jarifalamclaude-max/kill-Switch/docs/board_smd_bottom.png

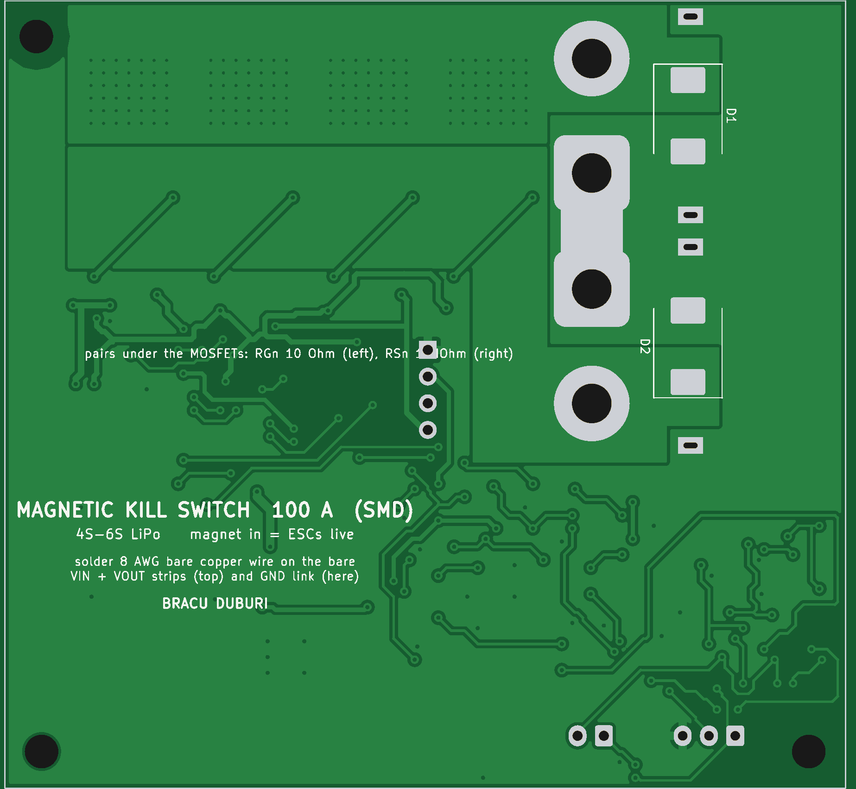
docs/board_smd_bottom.png
