jarifalamclaude-max/kill-Switch/docs/board_smd_layers.png

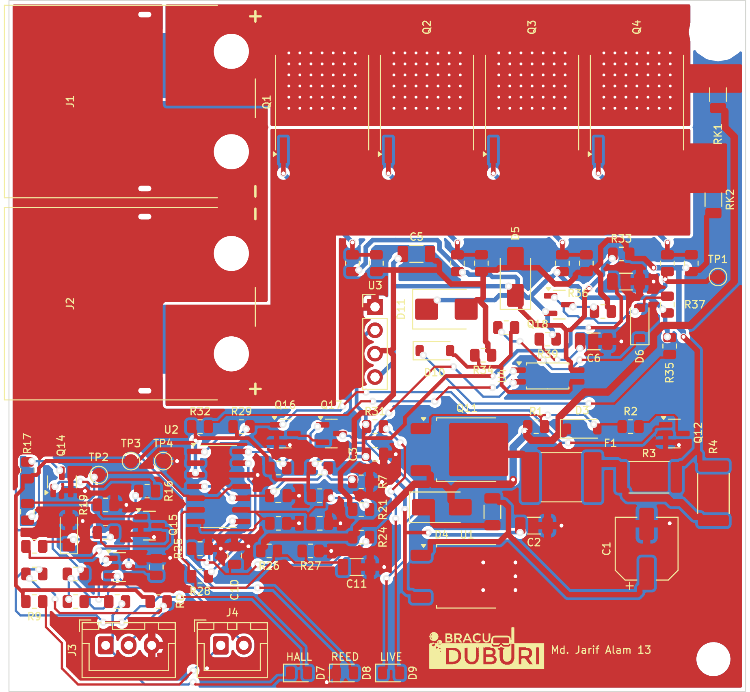
docs/board_smd_layers.png
