jarifalamclaude-max/kill-Switch/docs/board_smd_top.png

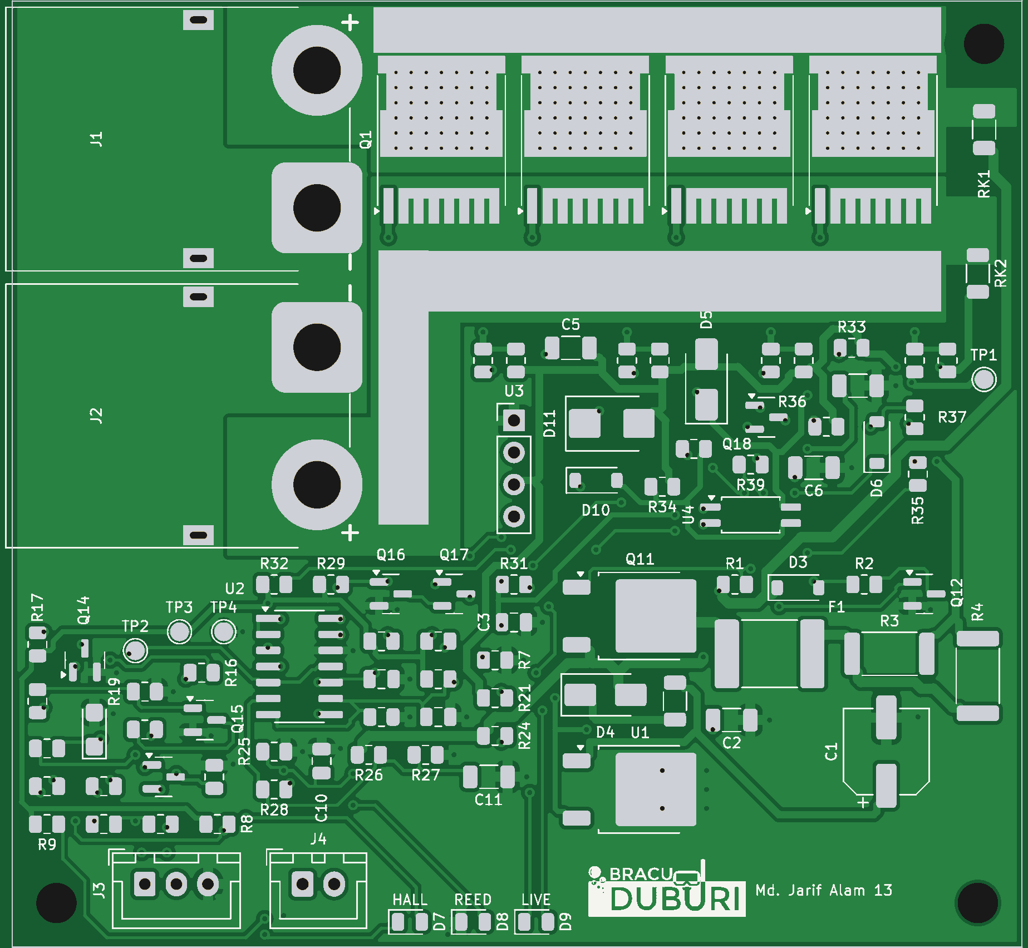
docs/board_smd_top.png
