jarifalamclaude-max/kill-Switch/docs/board_tht_bottom.png

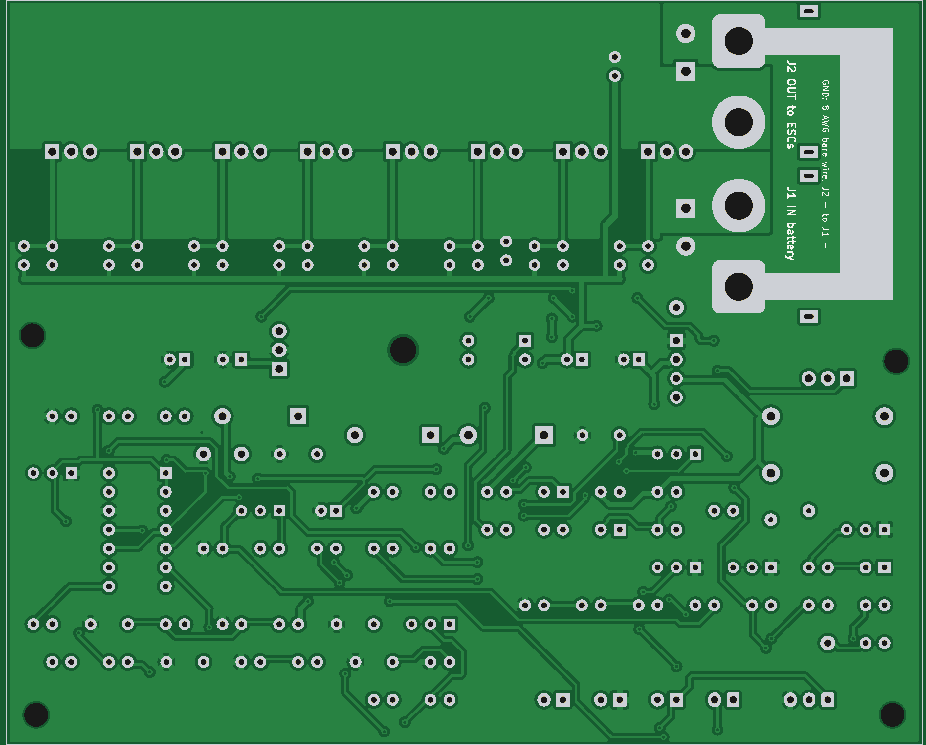
docs/board_tht_bottom.png
