jarifalamclaude-max/kill-Switch/docs/board_tht_layers.png

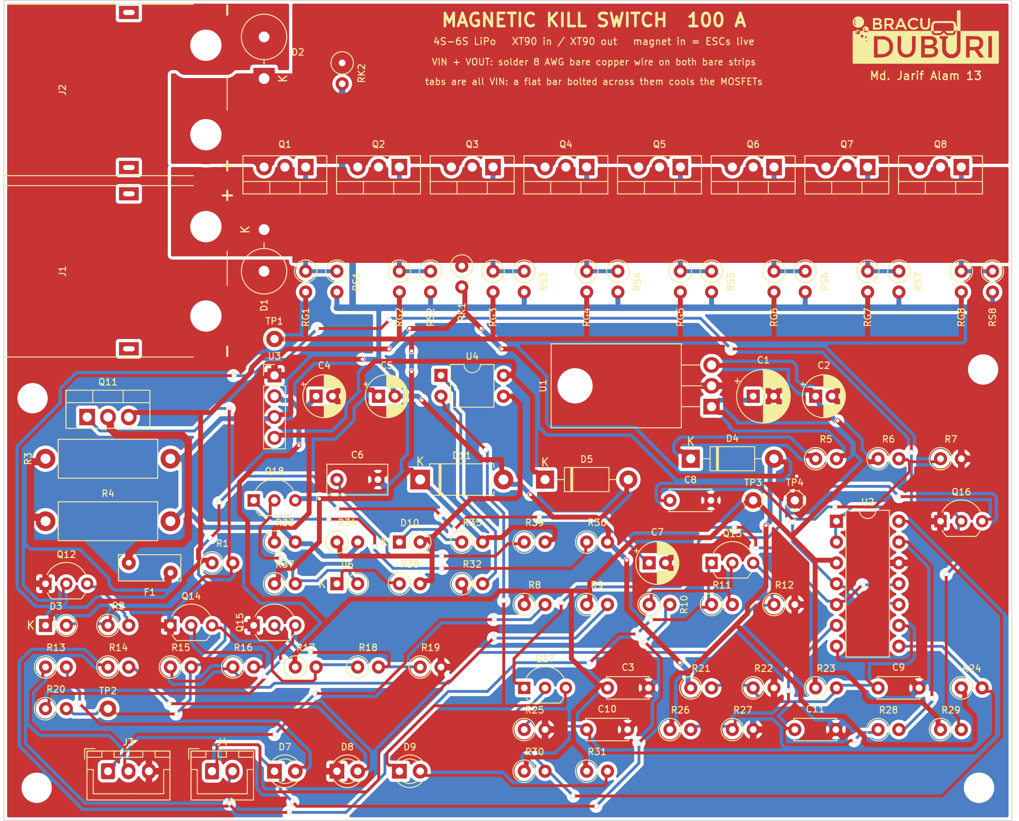
docs/board_tht_layers.png
