jarifalamclaude-max/kill-Switch/docs/board_top.png

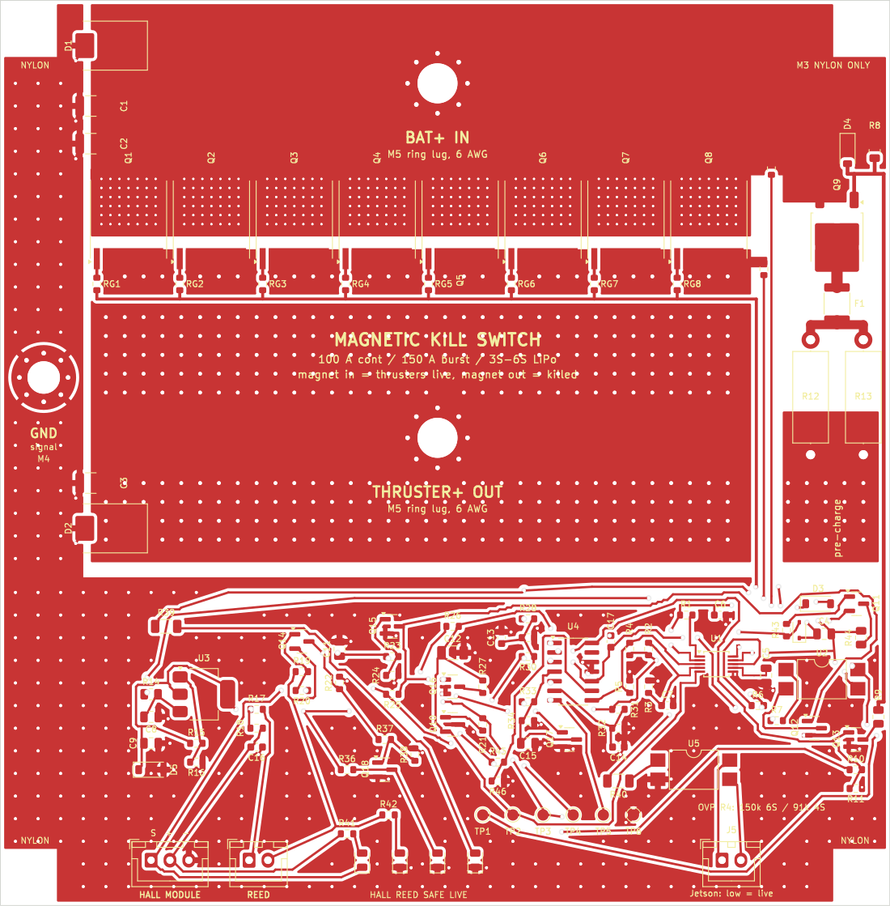
docs/board_top.png
