jarifalamclaude-max/kill-Switch/docs/kill_switch_tht_schematic.png

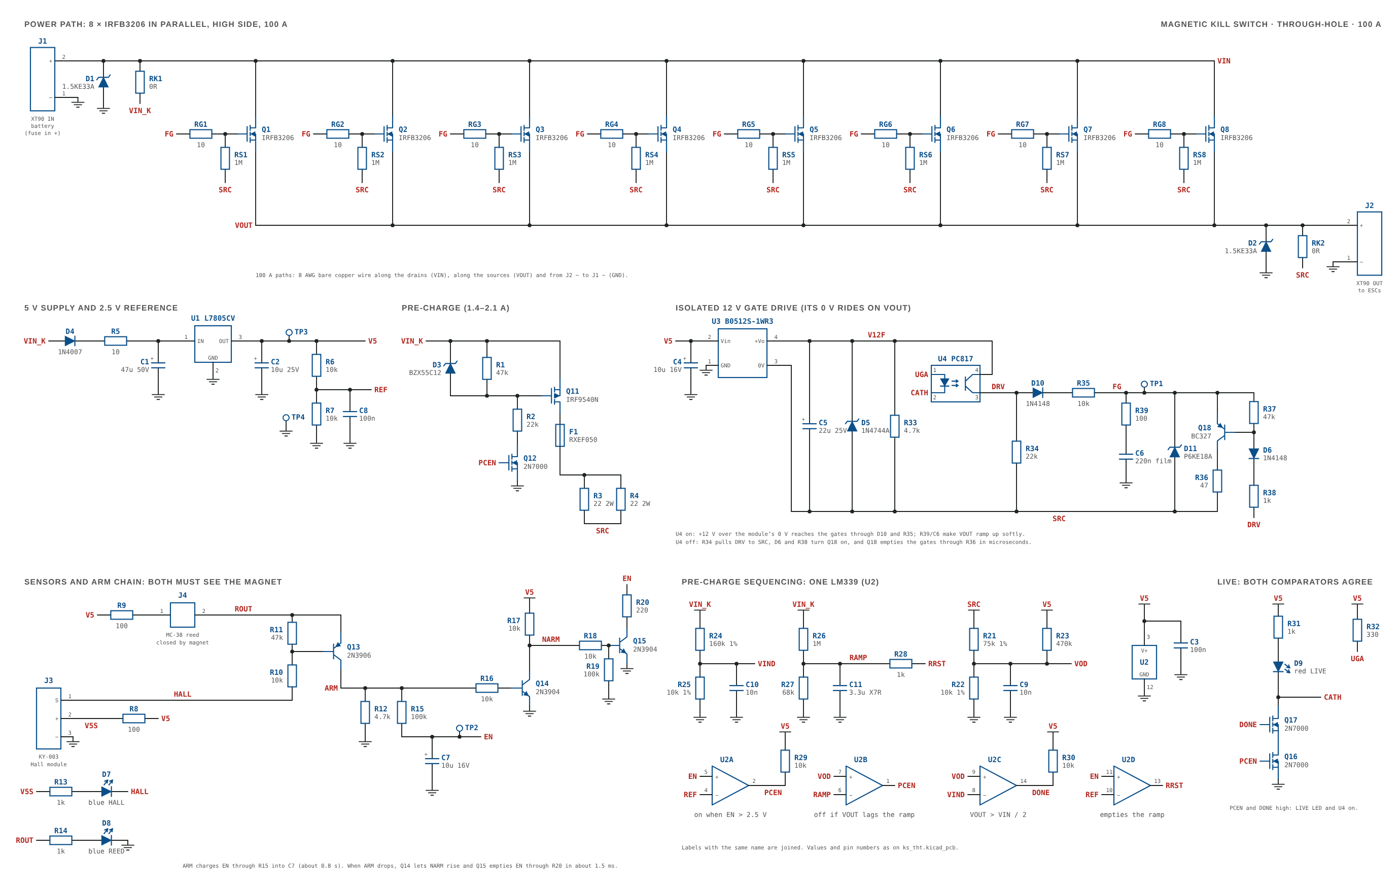
docs/kill_switch_tht_schematic.png
