jarifalamclaude-max/kill-Switch/kicad/simulation/copper_gnd.png

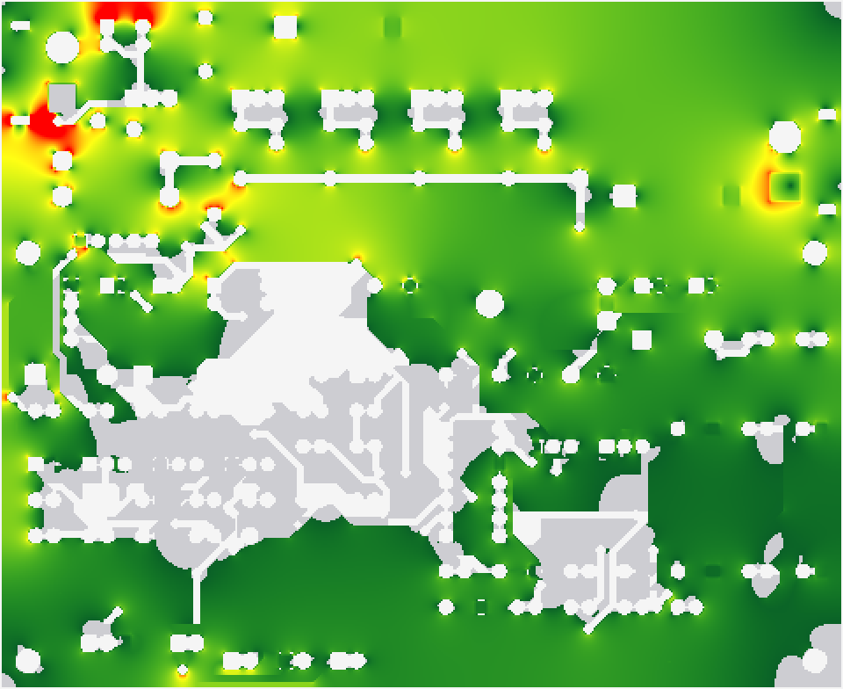
kicad/simulation/copper_gnd.png
