jarifalamclaude-max/kill-Switch/kicad/simulation/copper_gnd_wires.png

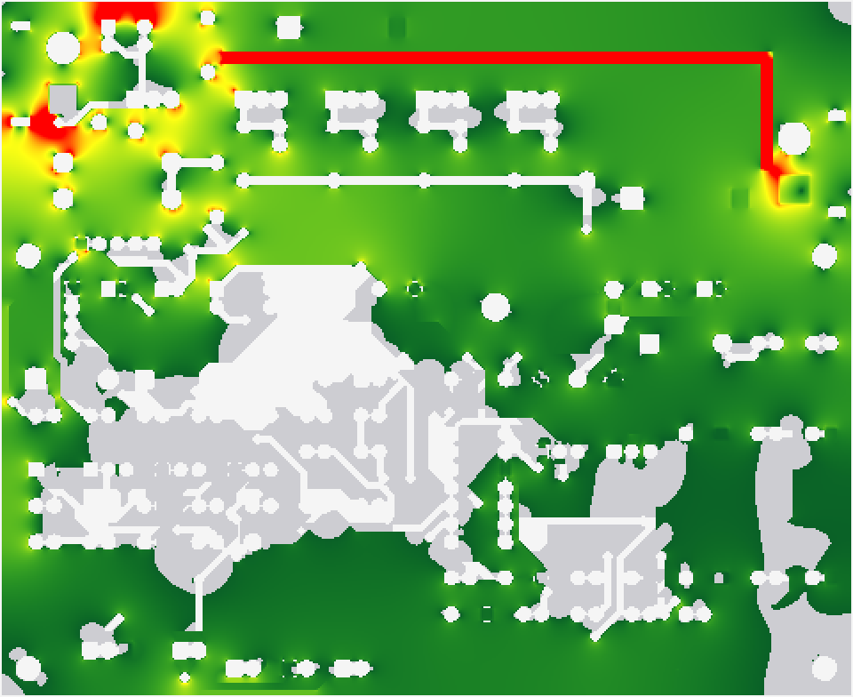
kicad/simulation/copper_gnd_wires.png
