jarifalamclaude-max/kill-Switch/kicad/simulation/copper_smd_gnd.png

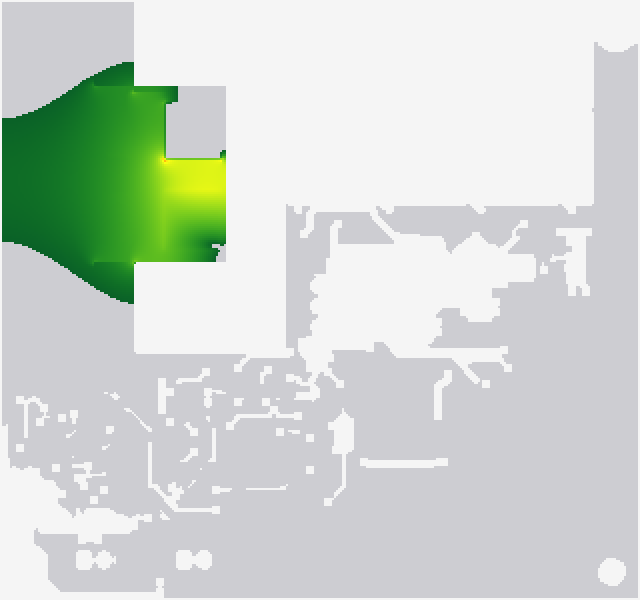
kicad/simulation/copper_smd_gnd.png
