jarifalamclaude-max/kill-Switch/kicad/simulation/copper_smd_gnd_wires.png

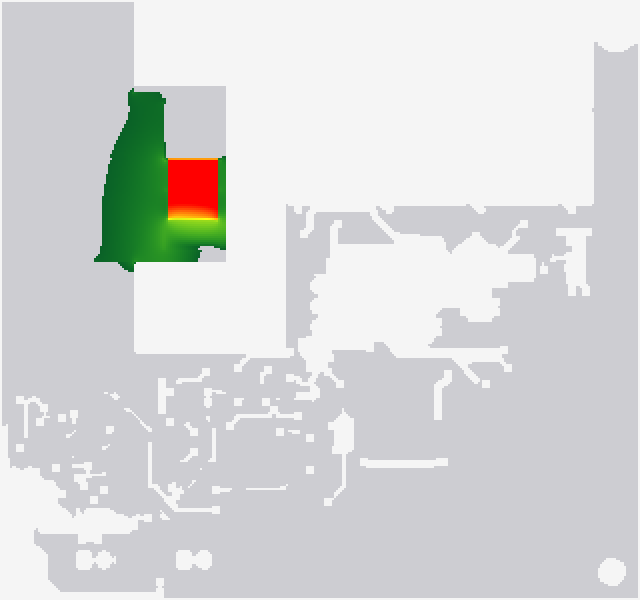
kicad/simulation/copper_smd_gnd_wires.png
