jarifalamclaude-max/kill-Switch/kicad/simulation/copper_smd_vin.png

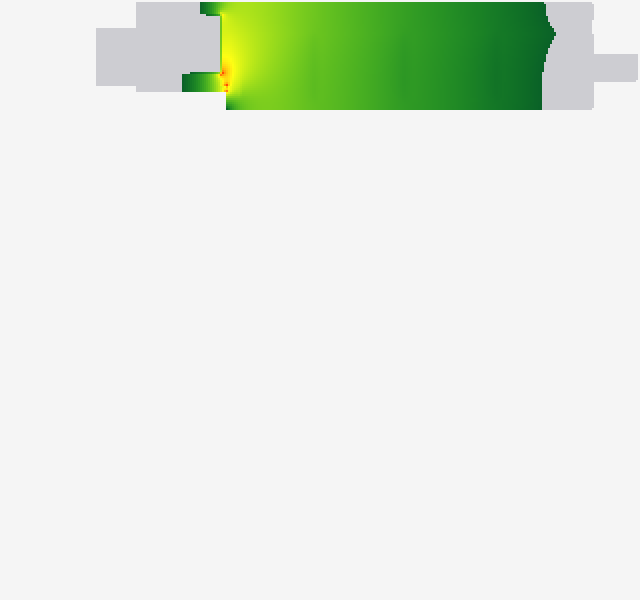
kicad/simulation/copper_smd_vin.png
