jarifalamclaude-max/kill-Switch/kicad/simulation/copper_smd_vout.png

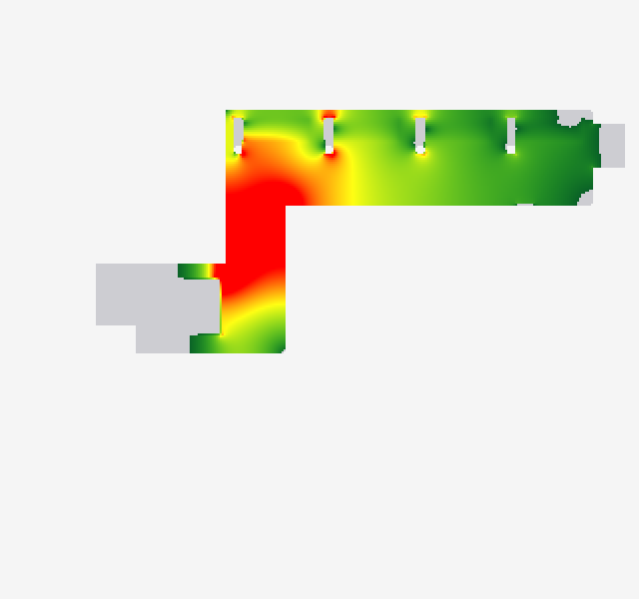
kicad/simulation/copper_smd_vout.png
