jarifalamclaude-max/kill-Switch/kicad/simulation/copper_tht_gnd.png

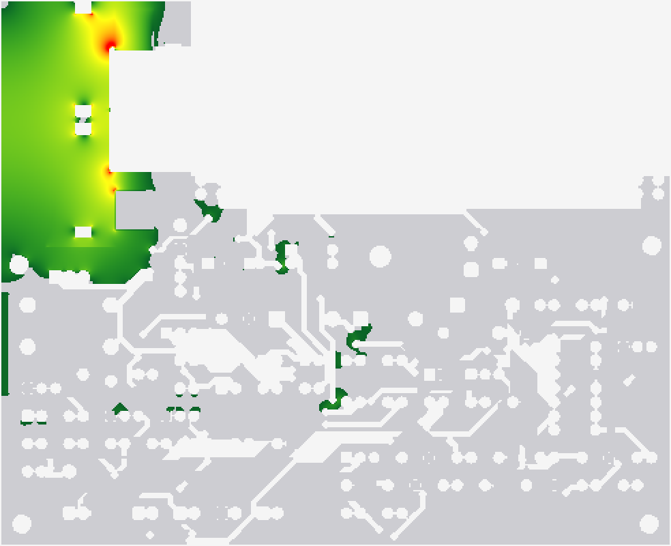
kicad/simulation/copper_tht_gnd.png
