jarifalamclaude-max/kill-Switch/kicad/simulation/copper_tht_vin.png

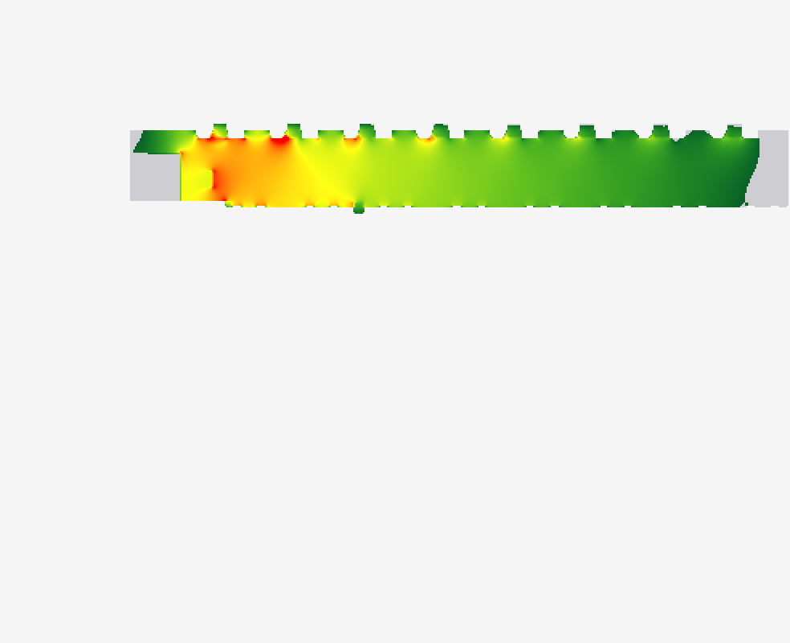
kicad/simulation/copper_tht_vin.png
