jarifalamclaude-max/kill-Switch/kicad/simulation/copper_tht_vin_wires.png

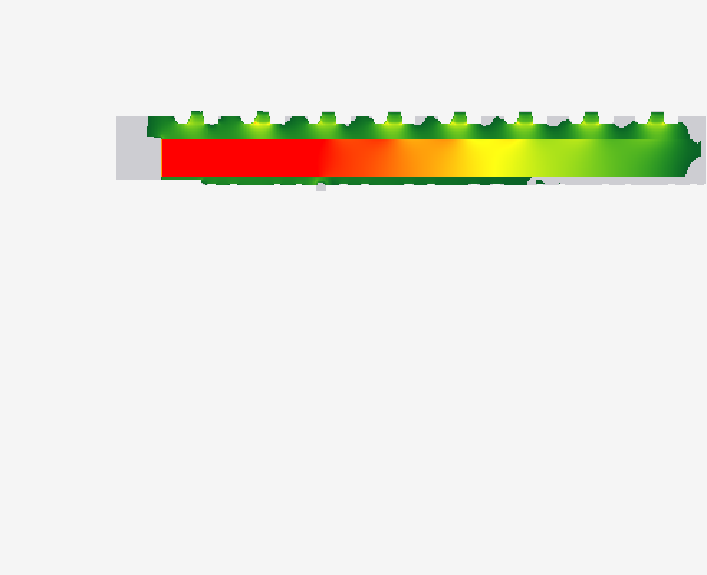
kicad/simulation/copper_tht_vin_wires.png
