jarifalamclaude-max/kill-Switch/kicad/simulation/copper_tht_vout_wires.png

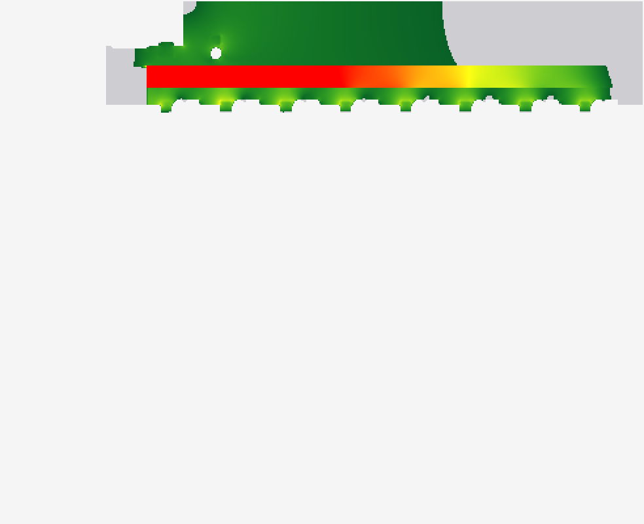
kicad/simulation/copper_tht_vout_wires.png
