jarifalamclaude-max/kill-Switch/kicad/simulation/copper_vin.png

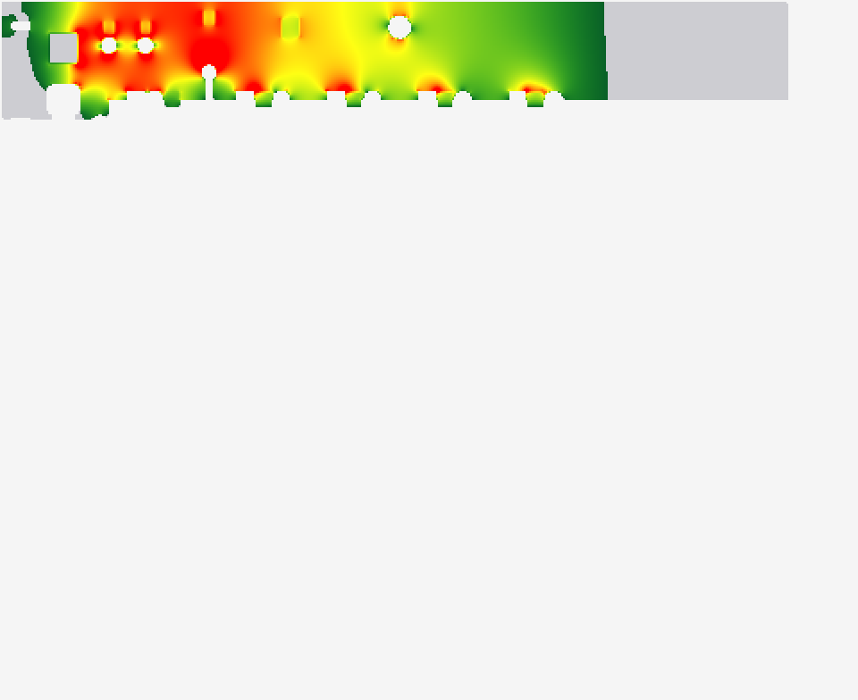
kicad/simulation/copper_vin.png
