jarifalamclaude-max/kill-Switch/kicad/simulation/copper_vin_wires.png

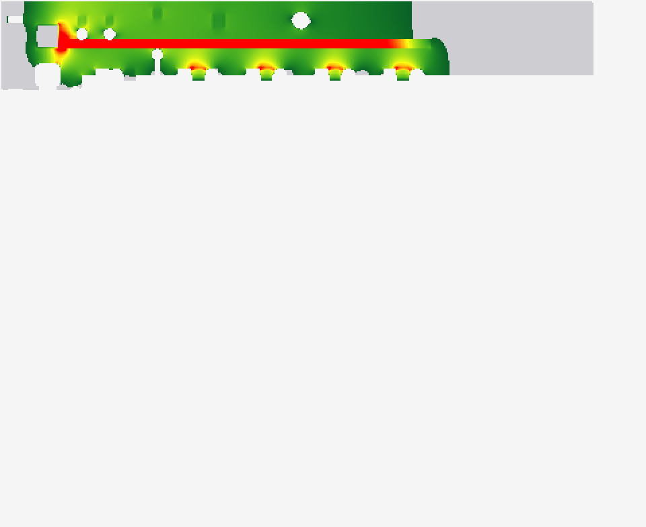
kicad/simulation/copper_vin_wires.png
