jarifalamclaude-max/kill-Switch/kicad/simulation/copper_vout.png

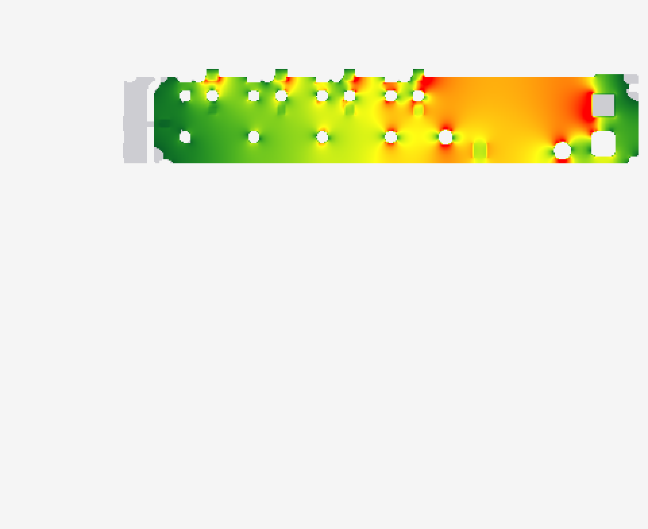
kicad/simulation/copper_vout.png
