jarifalamclaude-max/kill-Switch/kicad/simulation/copper_vout_wires.png

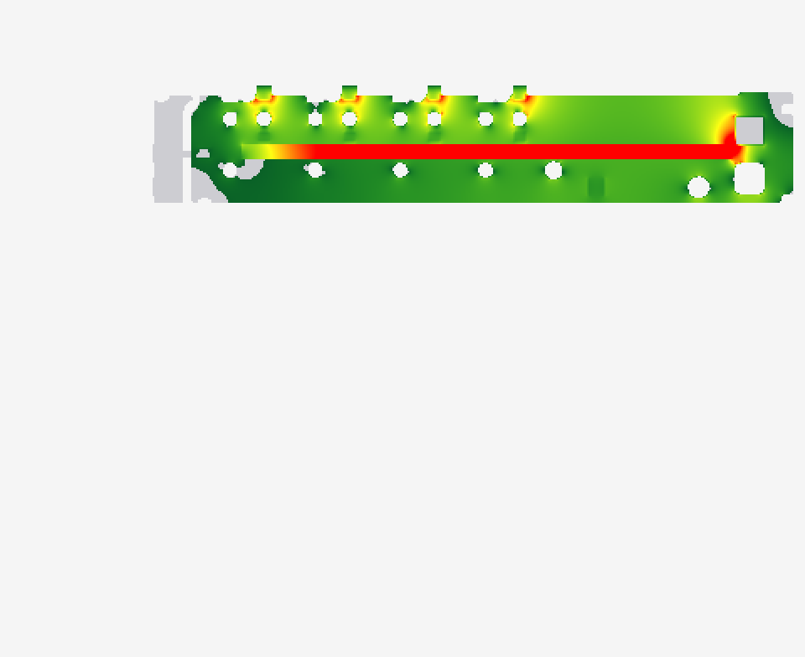
kicad/simulation/copper_vout_wires.png
