jarifalamclaude-max/kill-Switch/pcb-3d/tex_bot.jpg

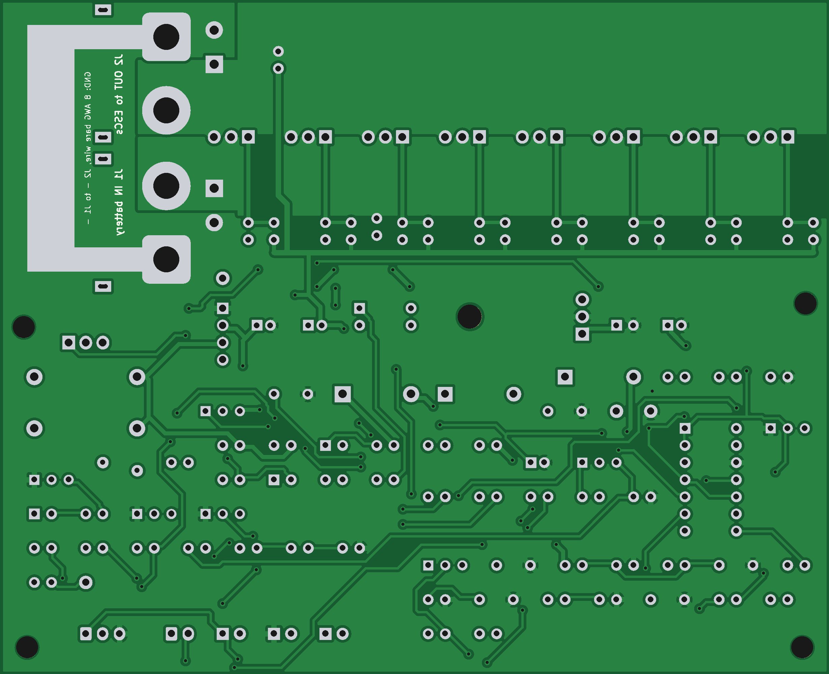
pcb-3d/tex_bot.jpg
