jarifalamclaude-max/kill-Switch/jlcpcb_smd/BOM_ks_smd.csv

Comment | Designator | Footprint | LCSC Part #
47u 50V | C1 | CP_Elec_6.3x7.7
10u 25V | C2,C4 | C_1206_3216Metric
100n | C3,C8 | C_0805_2012Metric
22u 25V | C5 | C_1206_3216Metric
220n 100V X7R | C6 | C_1206_3216Metric
10u 16V tantalum | C7 | CP_EIA-3216-18_Kemet-A
10n | C9,C10 | C_0805_2012Metric
3.3u X7R 50V | C11 | C_1206_3216Metric
SMCJ28A | D1,D2 | D_SMC
BZT52C12 | D3 | D_SOD-123
S1M | D4 | D_SMA
SMAZ15 | D5 | D_SMA
1N4148W | D6,D10 | D_SOD-123
blue HALL | D7 | LED_0805_2012Metric
blue REED | D8 | LED_0805_2012Metric
red LIVE | D9 | LED_0805_2012Metric
SMBJ15A | D11 | D_SMB
MF-SM050/60-2 (0.5 A, 60 V) | F1 | Fuse_2920_7451Metric
XT90PW-M battery IN | J1 | AMASS_XT90PW-M_1x02_P10.90mm_Horizontal
XT90PW-F ESC OUT | J2 | AMASS_XT90PW-F_1x02_P10.90mm_Horizontal
HALL MODULE (KY-003: S + -) | J3 | JST_XH_B3B-XH-A_1x03_P2.50mm_Vertical
REED (MC-38) | J4 | JST_XH_B2B-XH-A_1x02_P2.50mm_Vertical
IPT007N06N | Q1,Q2,Q3,Q4 | Infineon_PG-HSOF-8-1_ThermalVias
FQD11P06 | Q11 | TO-252-2
2N7002 | Q12,Q16,Q17 | SOT-23
MMBT3906 | Q13 | SOT-23
MMBT3904 | Q14,Q15 | SOT-23
BC807-40 | Q18 | SOT-23
47k | R1,R11,R37 | R_0805_2012Metric
22k | R2,R34 | R_0805_2012Metric
22 2512 | R3,R4 | R_2512_6332Metric
10 | R5 | R_1206_3216Metric
10k | R6,R7,R10,R16,R17,R18,R29,R30,R35 | R_0805_2012Metric
100 | R8,R9,R39 | R_0805_2012Metric
4.7k | R12,R33 | R_0805_2012Metric
1k | R13,R14,R28,R31,R38 | R_0805_2012Metric
100k | R15,R19 | R_0805_2012Metric
220 | R20 | R_0805_2012Metric
75k 1% | R21 | R_0805_2012Metric
10k 1% | R22,R25 | R_0805_2012Metric
470k | R23 | R_0805_2012Metric
160k 1% | R24 | R_0805_2012Metric
1M | R26,RS1,RS2,RS3,RS4 | R_0805_2012Metric
68k | R27 | R_0805_2012Metric
330 | R32 | R_0805_2012Metric
47 | R36 | R_0805_2012Metric
10 | RG1,RG2,RG3,RG4 | R_0805_2012Metric
0R | RK1,RK2 | R_1206_3216Metric
L7805CDT | U1 | TO-252-2
LM339D | U2 | SOIC-14_3.9x8.7mm_P1.27mm
B0512S-1WR3 | U3 | PinHeader_1x04_P2.54mm_Vertical
EL357N | U4 | SOP-4_4.4x2.6mm_P1.27mm
