jarifalamclaude-max/kill-Switch/kicad/bom_tht_grouped.csv

qty | value | footprint | refs | buy
1 | 47u 50V | CP_Radial_D6.3mm_P2.50mm | C1 | radial electrolytic 47u 50V
1 | 10u 25V | CP_Radial_D5.0mm_P2.00mm | C2 | radial electrolytic 10u 25V
2 | 100n | C_Disc_D5.0mm_W2.5mm_P5.00mm | C3 C8 | ceramic disc or MLCC radial 100n
2 | 10u 16V | CP_Radial_D5.0mm_P2.00mm | C4 C7 | radial electrolytic 10u 16V
1 | 22u 25V | CP_Radial_D5.0mm_P2.00mm | C5 | radial electrolytic 22u 25V
1 | 220n 100V film | C_Rect_L7.2mm_W3.5mm_P5.00mm_FKS2_FKP2_MKS2_MKP2 | C6 | 220 nF 100 V film (MKT/MKS), 5 mm pitch
2 | 10n | C_Disc_D5.0mm_W2.5mm_P5.00mm | C9 C10 | ceramic disc or MLCC radial 10n
1 | 3.3u X7R 50V | C_Disc_D5.0mm_W2.5mm_P5.00mm | C11 | 3.3 uF 50 V X7R radial ceramic (not electrolytic: its leakage would upset the ramp)
2 | 1.5KE33A | D_DO-201AE_P5.08mm_Vertical_KathodeUp | D1 D2 | 1.5KE33A TVS (DO-201, 1500 W, 28.2 V standoff)
1 | BZX55C12 | D_DO-35_SOD27_P2.54mm_Vertical_KathodeUp | D3 | BZX55C12 zener 12 V (DO-35)
1 | 1N4007 | D_DO-41_SOD81_P10.16mm_Horizontal | D4 | 1N4007 (DO-41)
1 | 1N4744A | D_DO-41_SOD81_P10.16mm_Horizontal | D5 | 1N4744A zener 15 V 1 W (DO-41)
2 | 1N4148 | D_DO-35_SOD27_P2.54mm_Vertical_KathodeUp | D6 D10 | 1N4148 (DO-35)
1 | blue HALL | LED_D3.0mm | D7 | 3 mm LED, blue
1 | blue REED | LED_D3.0mm | D8 | 3 mm LED, blue
1 | red LIVE | LED_D3.0mm | D9 | 3 mm LED, red
1 | P6KE18A | D_DO-15_P10.16mm_Horizontal | D11 | P6KE18A TVS (DO-15, 600 W, 15.3 V standoff)
1 | RXEF050 (0.5 A, 72 V) | Fuse_Bourns_MF-RHT050 | F1 | Littelfuse RXEF050 radial PTC (0.5 A hold, 72 V)
1 | XT90 IN (battery) | AMASS_XT90PW-M_1x02_P10.90mm_Horizontal | J1 | AMASS XT90PW-M (male, PCB right-angle, 2 x 3.8 mm holes) - mates with the battery's XT90; rated 45 A continuous / 90 A burst
1 | XT90 OUT (ESCs) | AMASS_XT90PW-F_1x02_P10.90mm_Horizontal | J2 | AMASS XT90PW-F (female, PCB right-angle) - the ESC harness plugs in here; rated 45 A continuous / 90 A burst
1 | HALL MODULE (KY-003: S + -) | JST_XH_B3B-XH-A_1x03_P2.50mm_Vertical | J3 | JST XH 3-pin header B3B-XH-A + housing XHP-3 for the KY-003 cable
1 | REED (MC-38) | JST_XH_B2B-XH-A_1x02_P2.50mm_Vertical | J4 | JST XH 2-pin header B2B-XH-A + housing XHP-2; MC-38 wired door contact (closed with the magnet)
8 | IRFB3206 | TO-220-3_Vertical | Q1 Q2 Q3 Q4 Q5 Q6 Q7 Q8 | Infineon IRFB3206PbF (TO-220, 60 V, 3.0 mOhm max at 10 V)
1 | IRF9540N | TO-220-3_Vertical | Q11 | IRF9540NPbF (TO-220, -100 V P-MOSFET)
3 | 2N7000 | TO-92_Inline_Wide | Q12 Q16 Q17 | 2N7000 (TO-92, pins S G D)
1 | 2N3906 | TO-92_Inline_Wide | Q13 | 2N3906 (TO-92, pins E B C)
2 | 2N3904 | TO-92_Inline_Wide | Q14 Q15 | 2N3904 (TO-92, pins E B C)
1 | BC327 | TO-92_Inline_Wide | Q18 | BC327-40 (TO-92, pins C B E)
3 | 47k | R_Axial_DIN0207_L6.3mm_D2.5mm_P2.54mm_Vertical | R1 R11 R37 | 1/4 W resistor 5% or 1%, stood up (2.54 mm)
2 | 22k | R_Axial_DIN0207_L6.3mm_D2.5mm_P2.54mm_Vertical | R2 R34 | 1/4 W resistor 5% or 1%, stood up (2.54 mm)
2 | 22 2W | R_Axial_DIN0414_L11.9mm_D4.5mm_P15.24mm_Horizontal | R3 R4 | 22 Ohm 2 W metal oxide or metal film, axial (pulse 1.5 J each)
9 | 10 | R_Axial_DIN0207_L6.3mm_D2.5mm_P2.54mm_Vertical | R5 RG1 RG2 RG3 RG4 RG5 RG6 RG7 RG8 | 1/4 W resistor 5% or 1%, stood up (2.54 mm)
9 | 10k | R_Axial_DIN0207_L6.3mm_D2.5mm_P2.54mm_Vertical | R6 R7 R10 R16 R17 R18 R29 R30 R35 | 1/4 W resistor 5% or 1%, stood up (2.54 mm)
3 | 100 | R_Axial_DIN0207_L6.3mm_D2.5mm_P2.54mm_Vertical | R8 R9 R39 | 1/4 W resistor 5% or 1%, stood up (2.54 mm)
2 | 4.7k | R_Axial_DIN0207_L6.3mm_D2.5mm_P2.54mm_Vertical | R12 R33 | 1/4 W resistor 5% or 1%, stood up (2.54 mm)
5 | 1k | R_Axial_DIN0207_L6.3mm_D2.5mm_P2.54mm_Vertical | R13 R14 R28 R31 R38 | 1/4 W resistor 5% or 1%, stood up (2.54 mm)
2 | 100k | R_Axial_DIN0207_L6.3mm_D2.5mm_P2.54mm_Vertical | R15 R19 | 1/4 W resistor 5% or 1%, stood up (2.54 mm)
1 | 220 | R_Axial_DIN0207_L6.3mm_D2.5mm_P2.54mm_Vertical | R20 | 1/4 W resistor 5% or 1%, stood up (2.54 mm)
1 | 75k 1% | R_Axial_DIN0207_L6.3mm_D2.5mm_P2.54mm_Vertical | R21 | 1/4 W resistor 1%, stood up (2.54 mm)
2 | 10k 1% | R_Axial_DIN0207_L6.3mm_D2.5mm_P2.54mm_Vertical | R22 R25 | 1/4 W resistor 1%, stood up (2.54 mm)
1 | 470k | R_Axial_DIN0207_L6.3mm_D2.5mm_P2.54mm_Vertical | R23 | 1/4 W resistor 5% or 1%, stood up (2.54 mm)
1 | 160k 1% | R_Axial_DIN0207_L6.3mm_D2.5mm_P2.54mm_Vertical | R24 | 1/4 W resistor 1%, stood up (2.54 mm)
9 | 1M | R_Axial_DIN0207_L6.3mm_D2.5mm_P2.54mm_Vertical | R26 RS1 RS2 RS3 RS4 RS5 RS6 RS7 RS8 | 1/4 W resistor 5% or 1%, stood up (2.54 mm)
1 | 68k | R_Axial_DIN0207_L6.3mm_D2.5mm_P2.54mm_Vertical | R27 | 1/4 W resistor 5% or 1%, stood up (2.54 mm)
1 | 330 | R_Axial_DIN0207_L6.3mm_D2.5mm_P2.54mm_Vertical | R32 | 1/4 W resistor 5% or 1%, stood up (2.54 mm)
1 | 47 | R_Axial_DIN0207_L6.3mm_D2.5mm_P2.54mm_Vertical | R36 | 1/4 W resistor 5% or 1%, stood up (2.54 mm)
2 | 0R | R_Axial_DIN0207_L6.3mm_D2.5mm_P2.54mm_Vertical | RK1 RK2 | 0 Ohm jumper (or a wire link)
1 | L7805CV | TO-220-3_Horizontal_TabDown | U1 | L7805CV (TO-220, tab = GND, lies flat on the board); a K7805-500R3 or R-78E5.0-0.5 switching module fits the same holes and runs cool
1 | LM339N | DIP-14_W7.62mm | U2 | LM339N (DIP-14) + socket
1 | B0512S-1WR3 | PinHeader_1x04_P2.54mm_Vertical | U3 | Mornsun B0512S-1WR3 (5 V -> 12 V isolated, 1 W, SIP-4): pins 1 GND, 2 Vin, 3 0V, 4 +Vo - check yours
1 | PC817 | DIP-4_W7.62mm | U4 | PC817 optocoupler (DIP-4)
1 | 8 AWG bare copper wire, about 0.35 m | - | - | solid 8 AWG (3.3 mm, 8.4 mm2) or bare earthing wire: one length on the VOUT strip, one on the VIN strip (top), a C-shaped piece on the GND strip (bottom)
1 | battery fuse 125-150 A | - | - | ANL / MIDI / MEGA fuse in the battery + lead, close to the battery (protects the wiring; the board itself switches off a dead short in under 1 ms)
2 | 8 AWG silicone cable | - | - | battery lead and ESC harness to the XT90 plugs, as short as possible
1 | optional: flat bar 3 x 15 mm, 92 mm long | - | - | copper or aluminium, 8 x M3 screw + nut + spring washer through the MOSFET tabs (all tabs are VIN, no insulators): extra cooling and an extra VIN path
4 | M3 nylon standoff + screw | - | - | board mounting (holes H1-H4)
