jarifalamclaude-max/kill-Switch/kicad/bom_grouped.csv

qty | value | footprint | refs | buy
3 | 2.2u 100V | C_1210_3225Metric | C1 C2 C3 | 1210 X7R ceramic, 100V
1 | 47n 50V | C_0805_2012Metric | C4 | 0805 X7R ceramic, 50V
1 | 470n | C_0805_2012Metric | C5 | 0805 X7R ceramic, 25 V or more
1 | 100n 100V | C_0603_1608Metric | C6 | 0603 X7R ceramic, 100V
3 | 10n | C_0603_1608Metric | C7 C13 C14 | 0603 X7R ceramic, 25 V or more
1 | 1u 50V | C_0805_2012Metric | C8 | 0805 X7R ceramic, 50V
1 | 10u 16V | C_0805_2012Metric | C9 | 0805 X7R ceramic, 16V
1 | 2.2u | C_0805_2012Metric | C11 | 0805 X7R ceramic, 25 V or more
1 | 22u 16V | C_1206_3216Metric | C12 | 1206 X7R ceramic, 16V
1 | 3.3u | C_0805_2012Metric | C15 | 0805 X7R ceramic, 25 V or more
2 | 100n | C_0603_1608Metric | C16 C17 | 0603 X7R ceramic, 25 V or more
1 | SMDJ26A | D_SMC | D1 | Littelfuse SMDJ26A (3 kW TVS, 26 V standoff, SMC)
1 | SMCJ26A | D_SMC | D2 | Littelfuse SMCJ26A (1.5 kW TVS, 26 V standoff, SMC)
1 | BZT52C15 | D_SOD-123 | D3 | BZT52C series zener, SOD-123
1 | BZT52C12 | D_SOD-123 | D4 | BZT52C series zener, SOD-123
1 | BZT52C6V2 | D_SOD-123 | D5 | BZT52C series zener, SOD-123
1 | blue HALL | LED_0805_2012Metric | D6 | 0805 LED, blue
1 | blue REED | LED_0805_2012Metric | D7 | 0805 LED, blue
1 | green SAFE | LED_0805_2012Metric | D8 | 0805 LED, green
1 | BAT54WS | D_SOD-323 | D9 | BAT54WS Schottky, SOD-323
1 | PTC 0.5A 30V 1812 | Fuse_1812_4532Metric | F1 | 1812 PTC fuse, hold 0.5 A, rated 30 V or more (60 V better for 6S) - verify the rating
1 | BAT+ IN (M5) | MountingHole_5.3mm_M5_Pad_Via | J1 | M5 ring lug, 6 AWG or thicker cable, M5 brass/stainless bolt + nut
1 | THRUSTER+ OUT (M5) | MountingHole_5.3mm_M5_Pad_Via | J2 | M5 ring lug, 6 AWG or thicker cable, M5 brass/stainless bolt + nut
1 | GND (M4) | MountingHole_4.3mm_M4_Pad_Via | J3 | M4 ring lug, thin wire to battery minus (logic ground only)
1 | HALL MODULE (KY-003: S + -) | JST_XH_B3B-XH-A_1x03_P2.50mm_Vertical | J4 | JST XH 3-pin header B3B-XH-A + housing XHP-3 for the KY-003 cable
1 | STATUS to Jetson | JST_XH_B2B-XH-A_1x02_P2.50mm_Vertical | J5 | JST XH 2-pin header B2B-XH-A + housing XHP-2
1 | REED CONTACT (MC-38) | JST_XH_B2B-XH-A_1x02_P2.50mm_Vertical | J6 | JST XH 2-pin header B2B-XH-A + housing XHP-2 for the MC-38 cable
1 | red LIVE | LED_0805_2012Metric | LED1 | 0805 LED, red
8 | IPT007N06N | Infineon_PG-HSOF-8-1_ThermalVias | Q1 Q2 Q3 Q4 Q5 Q6 Q7 Q8 | Infineon IPT007N06N (60 V, 0.75 mOhm max, TOLL)
1 | FQD11P06 | TO-252-2 | Q9 | onsemi FQD11P06TM (-60 V P-FET, DPAK)
2 | MMBT3906 | SOT-23 | Q10 Q11 | MMBT3906 PNP, SOT-23
6 | 2N7002 | SOT-23 | Q12 Q13 Q15 Q16 Q17 Q18 | 2N7002 N-FET, SOT-23
1 | BSS84 | SOT-23 | Q14 | BSS84 P-FET, SOT-23
1 | 4.32k 1% | R_0603_1608Metric | R1 | 0603 resistor 1%
2 | 47k | R_0603_1608Metric | R2 R34 | 0603 resistor 1% or 5%
5 | 10k | R_0603_1608Metric | R3 R5 R20 R23 R37 | 0603 resistor 1% or 5%
1 | 150k | R_0603_1608Metric | R4 | 0603 resistor 1% or 5%
7 | 100k | R_0603_1608Metric | R6 R10 R19 R24 R25 R26 R38 | 0603 resistor 1% or 5%
5 | 1k | R_0603_1608Metric | R7 R36 R41 R42 R43 | 0603 resistor 1% or 5%
1 | 47k | R_0805_2012Metric | R8 | 0805 resistor 1% or 5%
1 | 22k | R_0805_2012Metric | R9 | 0805 resistor 1% or 5%
3 | 1M | R_0603_1608Metric | R11 R30 R33 | 0603 resistor 1% or 5%
2 | 22 2W | R_Axial_DIN0414_L11.9mm_D4.5mm_P15.24mm_Horizontal | R12 R13 | 22 Ohm 2 W metal oxide or metal film, axial (pulse 1.5 J each)
1 | 10 | R_0805_2012Metric | R14 | 0805 resistor 1% or 5%
1 | 240 1% | R_0603_1608Metric | R15 | 0603 resistor 1%
1 | 750 1% | R_0603_1608Metric | R16 | 0603 resistor 1%
2 | 100 | R_0603_1608Metric | R17 R18 | 0603 resistor 1% or 5%
1 | 4.7k | R_0603_1608Metric | R21 | 0603 resistor 1% or 5%
1 | 2.2k | R_0603_1608Metric | R22 | 0603 resistor 1% or 5%
9 | 10 | R_0603_1608Metric | R27 RG1 RG2 RG3 RG4 RG5 RG6 RG7 RG8 | 0603 resistor 1% or 5%
1 | 90.9k 1% | R_0603_1608Metric | R28 | 0603 resistor 1%
3 | 10k 1% | R_0603_1608Metric | R29 R32 R46 | 0603 resistor 1%
1 | 191k 1% | R_0603_1608Metric | R31 | 0603 resistor 1%
1 | 4.7k | R_1206_3216Metric | R39 | 1206 resistor 1% or 5%
1 | 10k | R_1206_3216Metric | R40 | 1206 resistor 1% or 5%
1 | 220 | R_0805_2012Metric | R44 | 0805 resistor 1% or 5%
1 | 15.8k 1% | R_0603_1608Metric | R45 | 0603 resistor 1%
1 | 0R (VIN Kelvin) | R_0603_1608Metric | RK1 | 0603 resistor 1% or 5%, 0 Ohm jumper
1 | 0R (VOUT Kelvin) | R_0603_1608Metric | RK2 | 0603 resistor 1% or 5%, 0 Ohm jumper
1 | LM5060 | MSOP-10_3x3mm_P0.5mm | U1 | TI LM5060MM/NOPB (VSSOP-10)
1 | PC817 (gate kill) | SMDIP-4_W9.53mm | U2 | Sharp/Everlight PC817 SMD (SMDIP-4, gull wing)
1 | LM317 | SOT-223-3_TabPin2 | U3 | LM317 in SOT-223 (e.g. LM317DCYR)
1 | LM339 | SOIC-14_3.9x8.7mm_P1.27mm | U4 | LM339DR or LM339ADR (SOIC-14)
1 | PC817 (status) | SMDIP-4_W9.53mm | U5 | Sharp/Everlight PC817 SMD (SMDIP-4, gull wing)
