jarifalamclaude-max/kill-Switch/kicad/3dmodels/JST_XH_B2B-XH-A_1x02_P2.50mm_Vertical.step

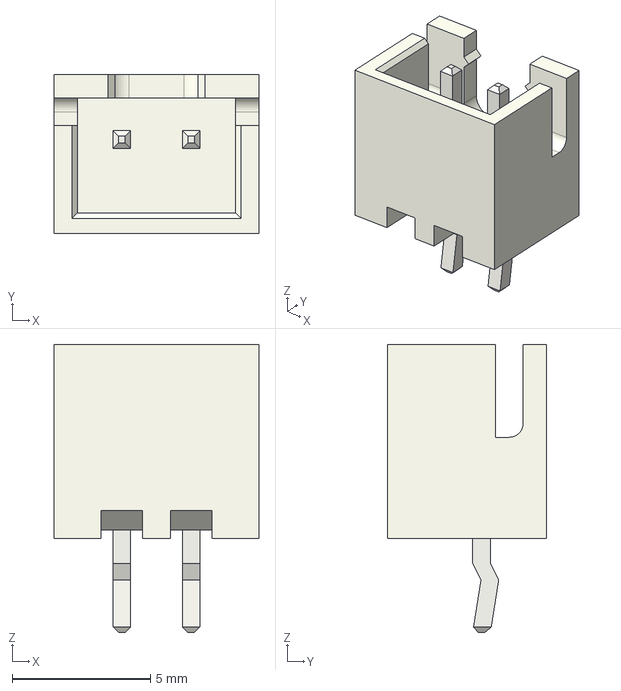
[picture p24: CAD file, 2026-11-12]
kicad/3dmodels/JST_XH_B2B-XH-A_1x02_P2.50mm_Vertical.step
7.40 x 5.75 x 10.4 mm
