jarifalamclaude-max/kill-Switch/mech/bracket.stl

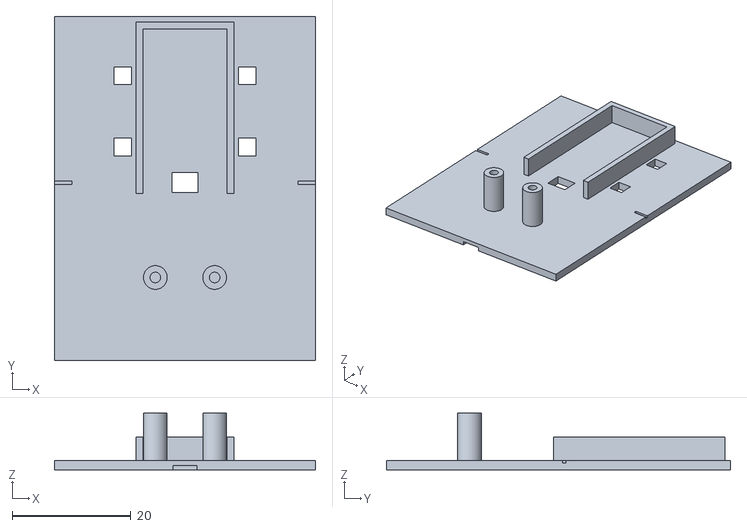
[picture p25: CAD file, 2026-11-12]
mech/bracket.stl
44.0 x 58.0 x 9.60
