jarifalamclaude-max/kill-Switch/kicad/3dmodels/CP_Radial_D6.3mm_P2.50mm.step

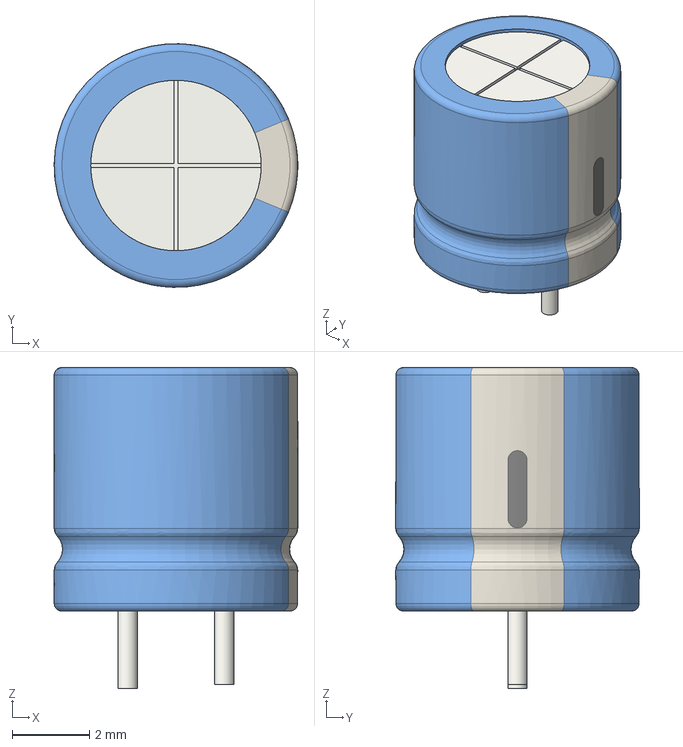
[picture p26: CAD file, 2026-11-12]
kicad/3dmodels/CP_Radial_D6.3mm_P2.50mm.step
6.30 x 6.30 x 8.30 mm
