jarifalamclaude-max/kill-Switch/mech/handle.stl

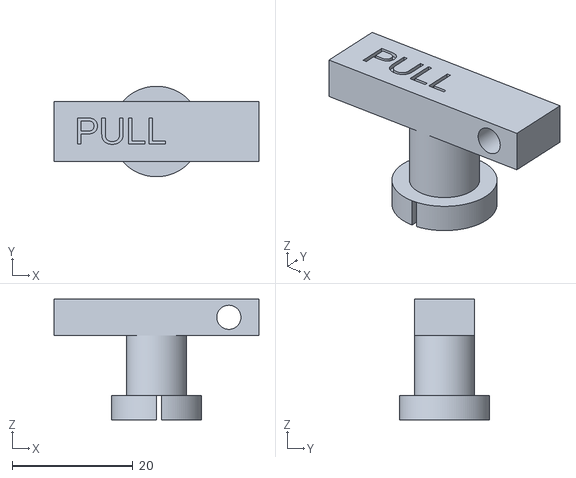
[picture p27: CAD file, 2026-11-12]
mech/handle.stl
34.0 x 15.0 x 20.0
