jarifalamclaude-max/kill-Switch/kicad/3dmodels/C_Rect_L7.2mm_W3.5mm_P5.00mm_FKS2_FKP2_MKS2_MKP2.step

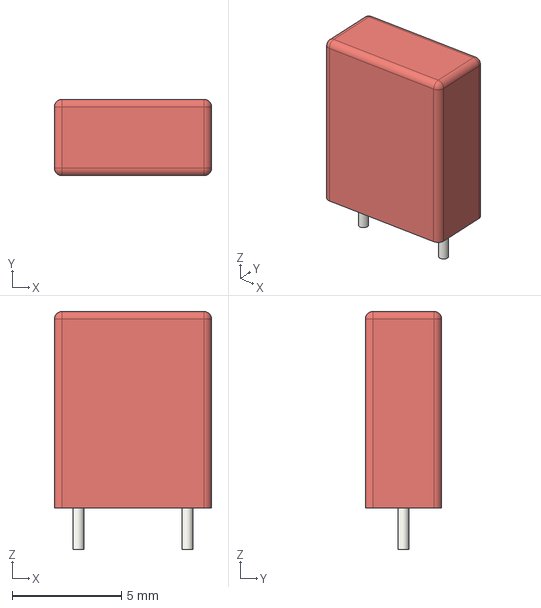
[picture p28: CAD file, 2026-11-12]
kicad/3dmodels/C_Rect_L7.2mm_W3.5mm_P5.00mm_FKS2_FKP2_MKS2_MKP2.step
7.20 x 3.50 x 10.9 mm
