jarifalamclaude-max/kill-Switch/mech/plug.stl

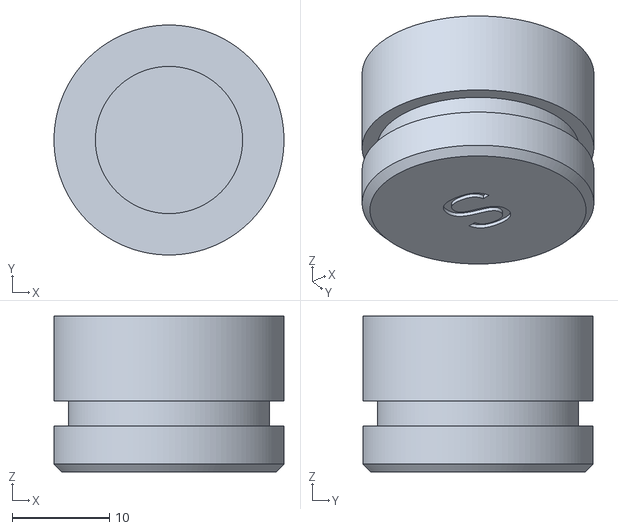
[picture p29: CAD file, 2026-11-12]
mech/plug.stl
23.6 x 23.6 x 16.0
