jarifalamclaude-max/kill-Switch/mech/dock.stl

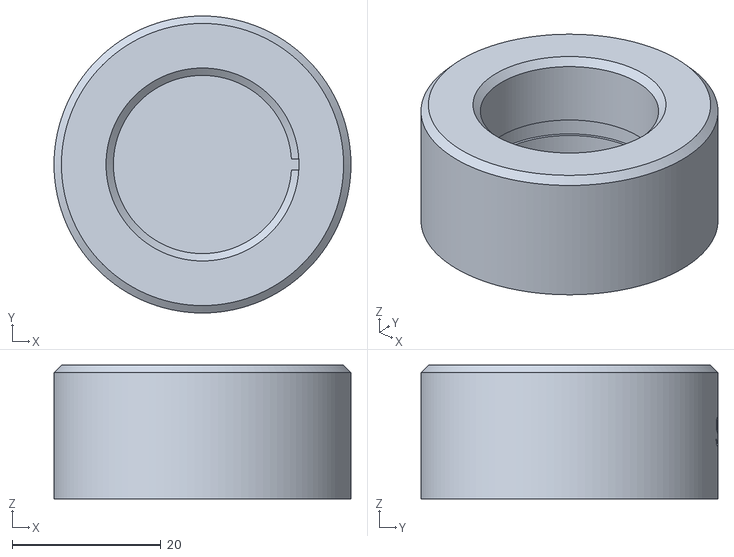
[picture p31: CAD file, 2026-11-12]
mech/dock.stl
40.0 x 40.0 x 18.0
