jarifalamclaude-max/kill-Switch/kicad/3dmodels/CP_EIA-3216-18_Kemet-A.step

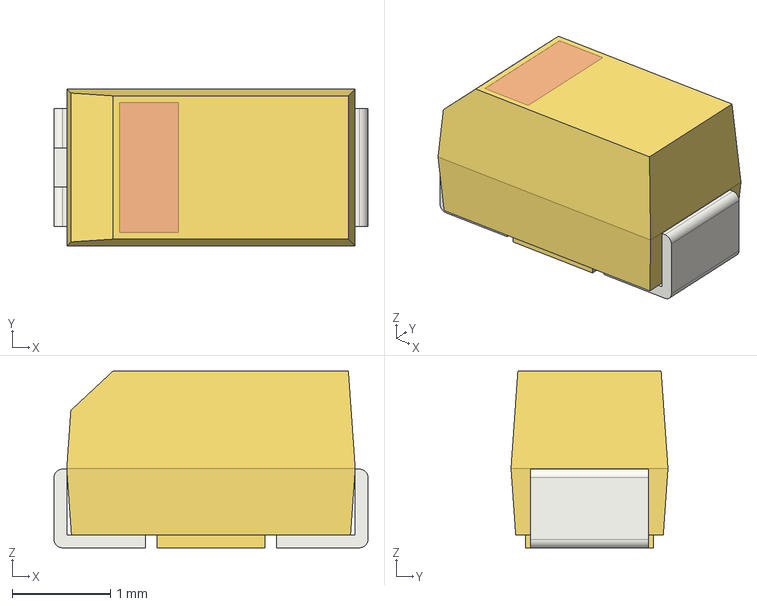
[picture p32: CAD file, 2026-11-12]
kicad/3dmodels/CP_EIA-3216-18_Kemet-A.step
3.20 x 1.60 x 1.80 mm
