jarifalamclaude-max/kill-Switch/kicad/3dmodels/PinHeader_1x04_P2.54mm_Vertical.step

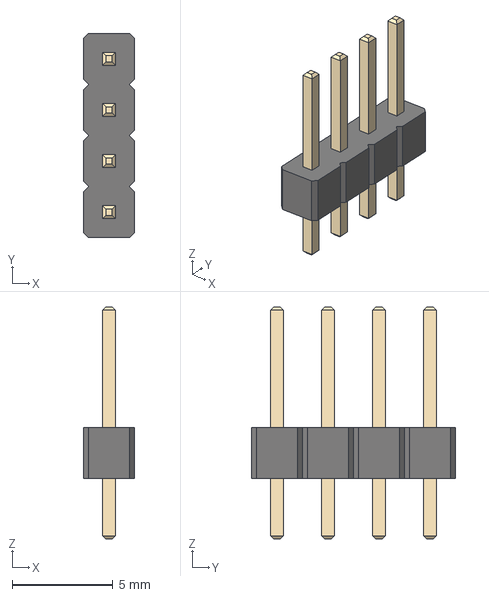
[picture p33: CAD file, 2026-11-12]
kicad/3dmodels/PinHeader_1x04_P2.54mm_Vertical.step
2.54 x 10.2 x 11.5 mm
