jarifalamclaude-max/kill-Switch/kicad/3dmodels/SOIC-14_3.9x8.7mm_P1.27mm.step

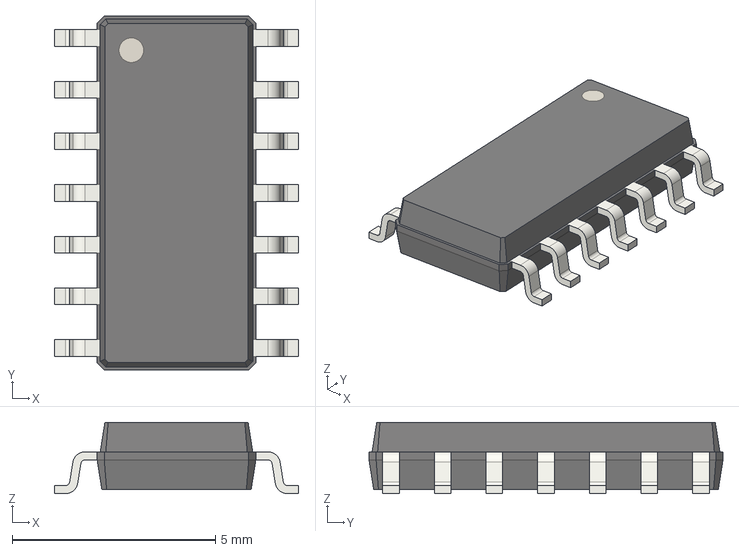
[picture p34: CAD file, 2026-11-12]
kicad/3dmodels/SOIC-14_3.9x8.7mm_P1.27mm.step
6.00 x 8.70 x 1.75 mm
