jarifalamclaude-max/kill-Switch/kicad/3dmodels/R_0805_2012Metric.step

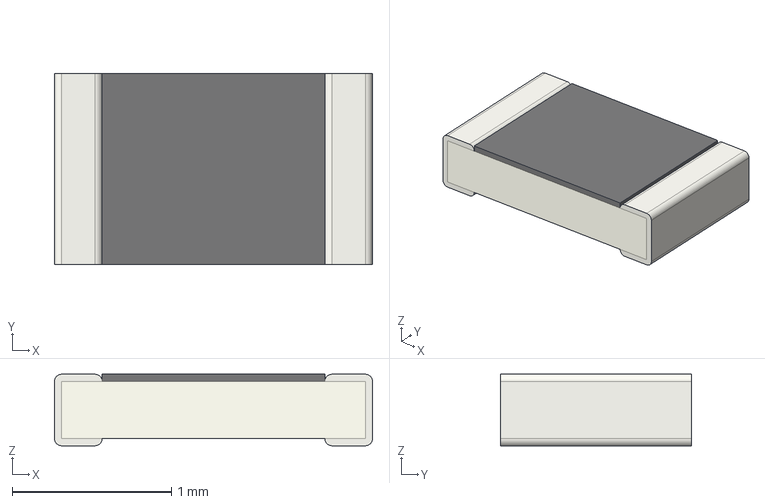
[picture p35: CAD file, 2026-11-12]
kicad/3dmodels/R_0805_2012Metric.step
2.00 x 1.20 x 0.45 mm
