jarifalamclaude-max/kill-Switch/kicad/3dmodels/C_0805_2012Metric.step

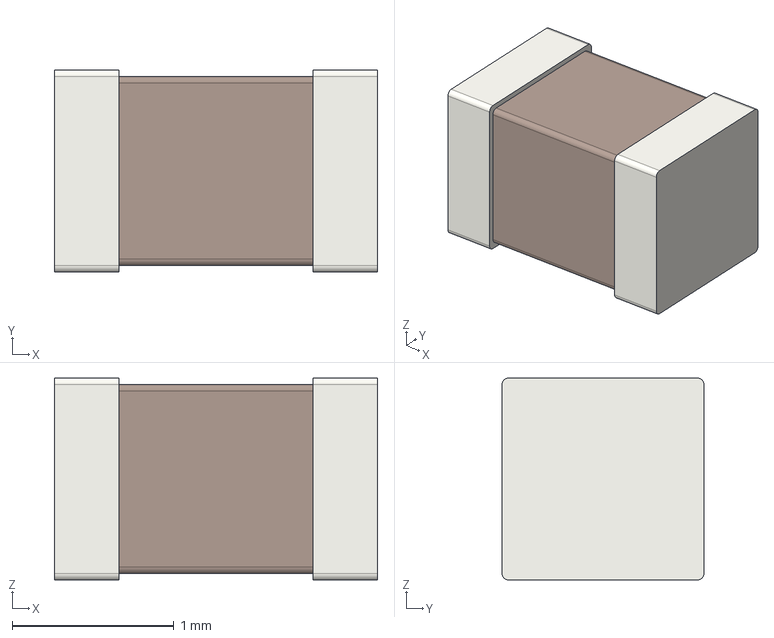
[picture p36: CAD file, 2026-11-12]
kicad/3dmodels/C_0805_2012Metric.step
2.00 x 1.25 x 1.25 mm
