jarifalamclaude-max/kill-Switch/kicad/3dmodels/D_DO-35_SOD27_P2.54mm_Vertical_KathodeUp.step

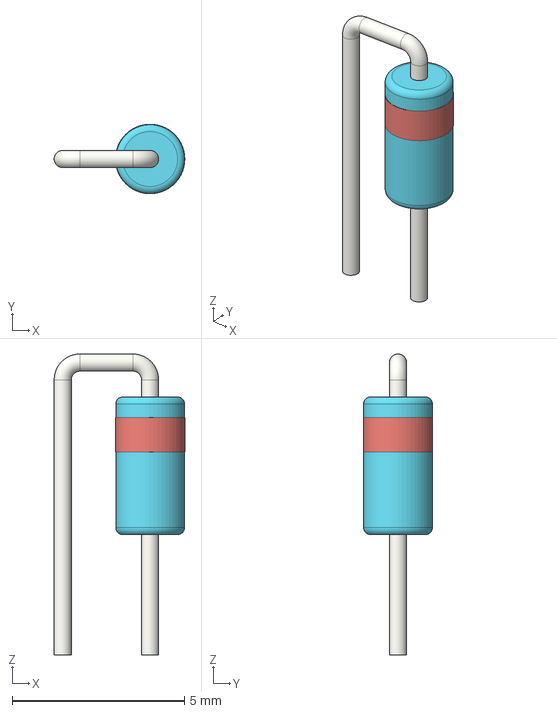
[picture p37: CAD file, 2026-11-12]
kicad/3dmodels/D_DO-35_SOD27_P2.54mm_Vertical_KathodeUp.step
3.80 x 2.02 x 8.75 mm
