jarifalamclaude-max/kill-Switch/kicad/3dmodels/D_SMA.step

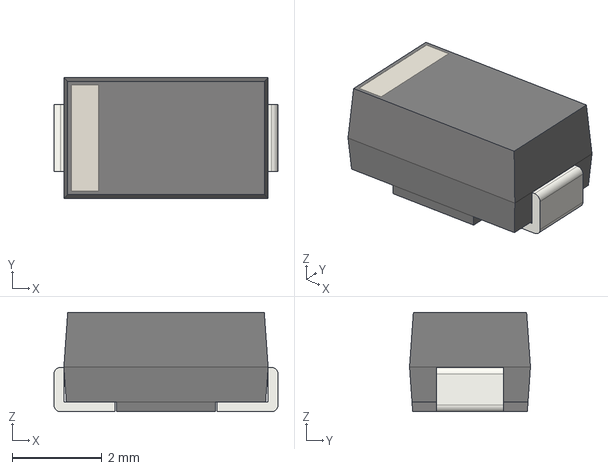
[picture p38: CAD file, 2026-11-12]
kicad/3dmodels/D_SMA.step
5.00 x 2.70 x 2.22 mm
