jarifalamclaude-max/kill-Switch/kicad/3dmodels/JST_XH_B3B-XH-A_1x03_P2.50mm_Vertical.step

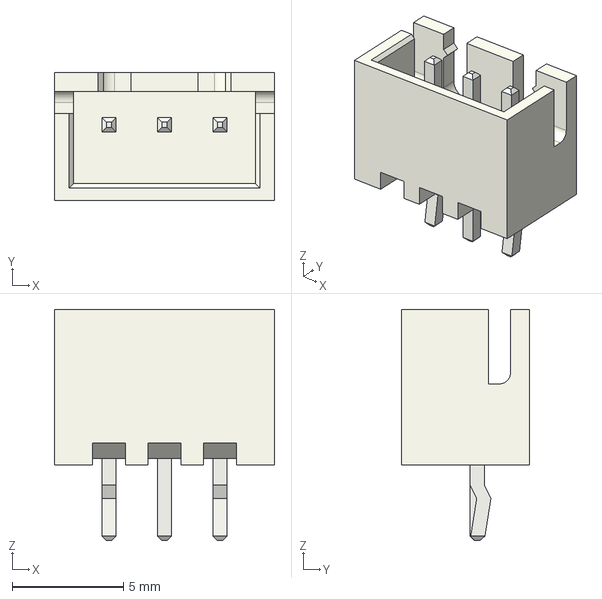
[picture p39: CAD file, 2026-11-12]
kicad/3dmodels/JST_XH_B3B-XH-A_1x03_P2.50mm_Vertical.step
9.90 x 5.75 x 10.4 mm
