jarifalamclaude-max/kill-Switch/kicad/3dmodels/D_DO-201AE_P5.08mm_Vertical_KathodeUp.step

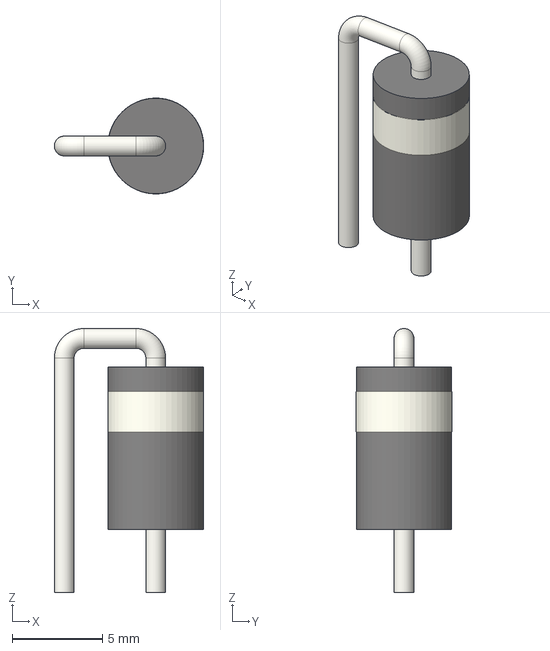
[picture p40: CAD file, 2026-11-12]
kicad/3dmodels/D_DO-201AE_P5.08mm_Vertical_KathodeUp.step
8.29 x 5.32 x 14.6 mm
