jarifalamclaude-max/kill-Switch/kicad/3dmodels/C_1206_3216Metric.step

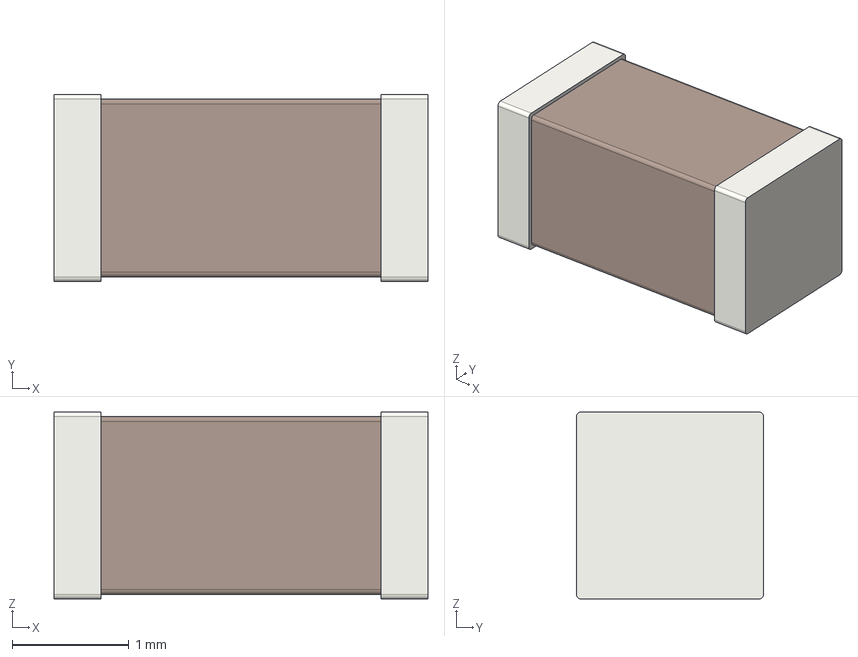
[picture p41: CAD file, 2026-11-12]
kicad/3dmodels/C_1206_3216Metric.step
3.20 x 1.60 x 1.60 mm
