jarifalamclaude-max/kill-Switch/kicad/3dmodels/DIP-4_W7.62mm.step

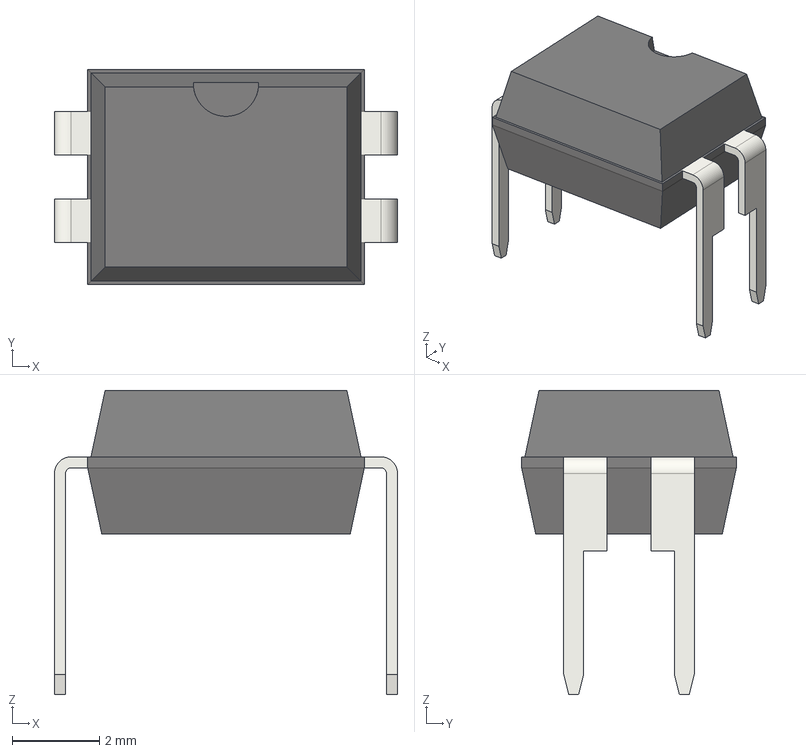
[picture p42: CAD file, 2026-11-12]
kicad/3dmodels/DIP-4_W7.62mm.step
7.87 x 4.93 x 6.98 mm
