jarifalamclaude-max/kill-Switch/kicad/3dmodels/TO-220-3_Horizontal_TabDown.step

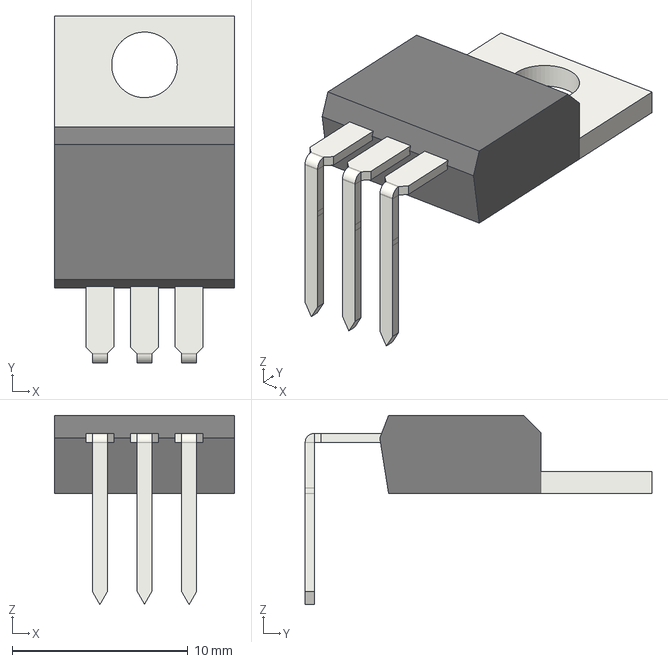
[picture p43: CAD file, 2026-11-12]
kicad/3dmodels/TO-220-3_Horizontal_TabDown.step
10.2 x 19.7 x 10.8 mm
