jarifalamclaude-max/kill-Switch/kicad/3dmodels/R_Axial_DIN0414_L11.9mm_D4.5mm_P15.24mm_Horizontal.step

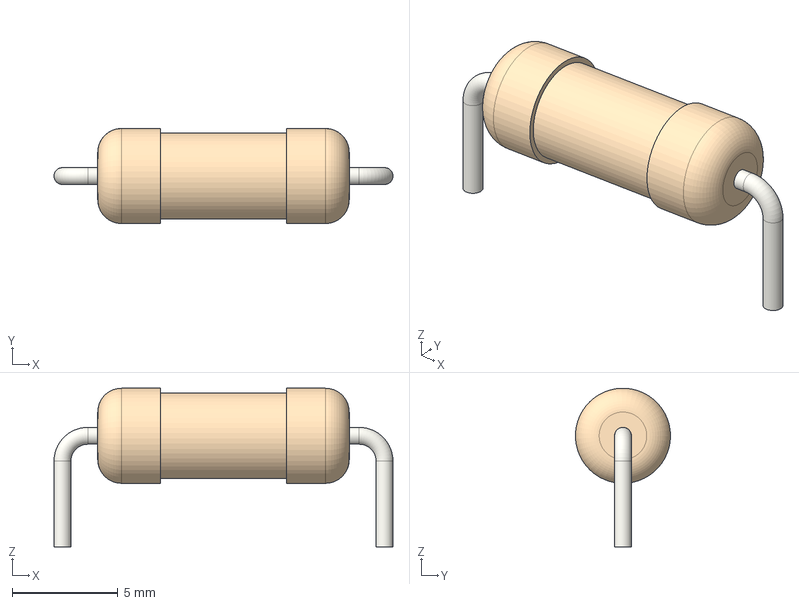
[picture p44: CAD file, 2026-11-12]
kicad/3dmodels/R_Axial_DIN0414_L11.9mm_D4.5mm_P15.24mm_Horizontal.step
16.0 x 4.50 x 7.50 mm
