jarifalamclaude-max/kill-Switch/kicad/3dmodels/R_Axial_DIN0207_L6.3mm_D2.5mm_P2.54mm_Vertical.step

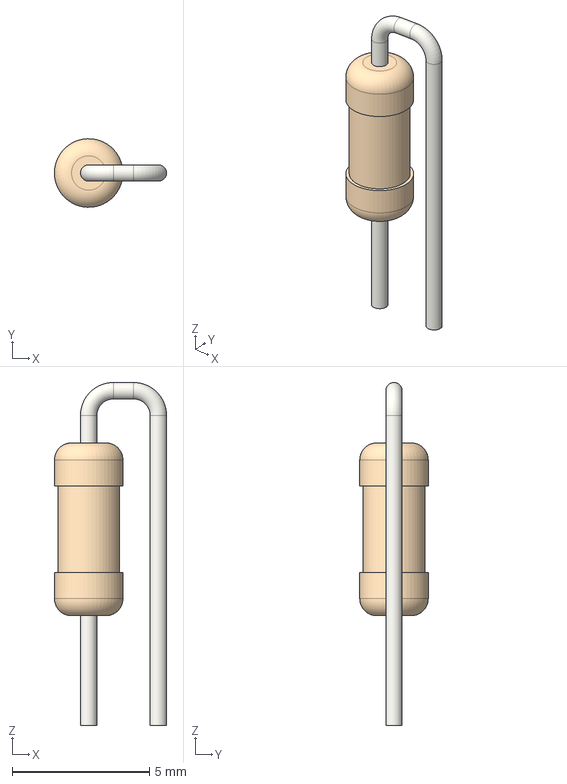
[picture p45: CAD file, 2026-11-12]
kicad/3dmodels/R_Axial_DIN0207_L6.3mm_D2.5mm_P2.54mm_Vertical.step
4.09 x 2.50 x 12.5 mm
