jarifalamclaude-max/kill-Switch/kicad/3dmodels/CP_Elec_6.3x7.7.step

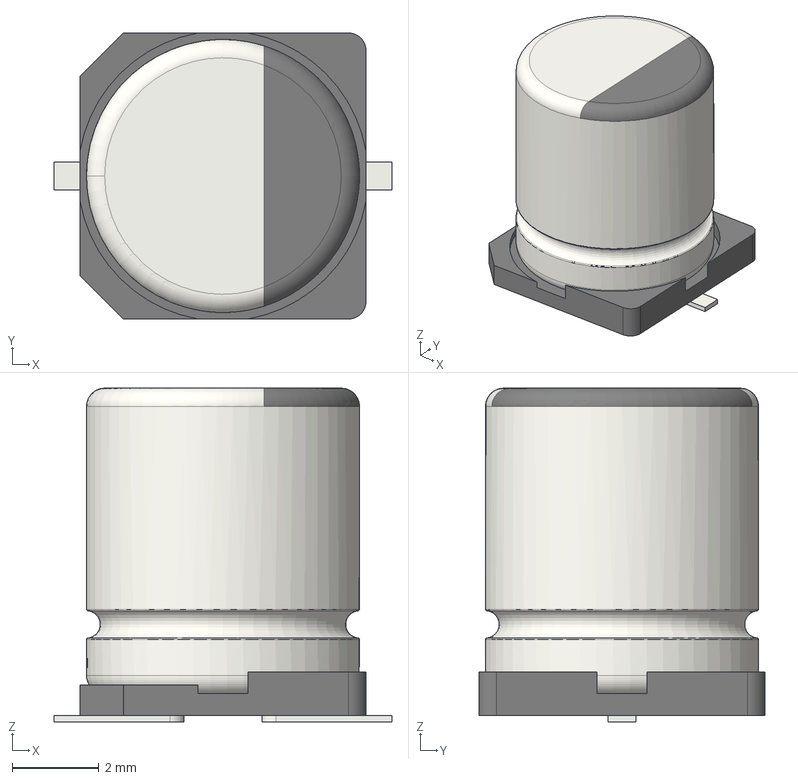
[picture p46: CAD file, 2026-11-12]
kicad/3dmodels/CP_Elec_6.3x7.7.step
7.80 x 6.60 x 7.70 mm
