jarifalamclaude-max/kill-Switch/kicad/3dmodels/D_SMB.step

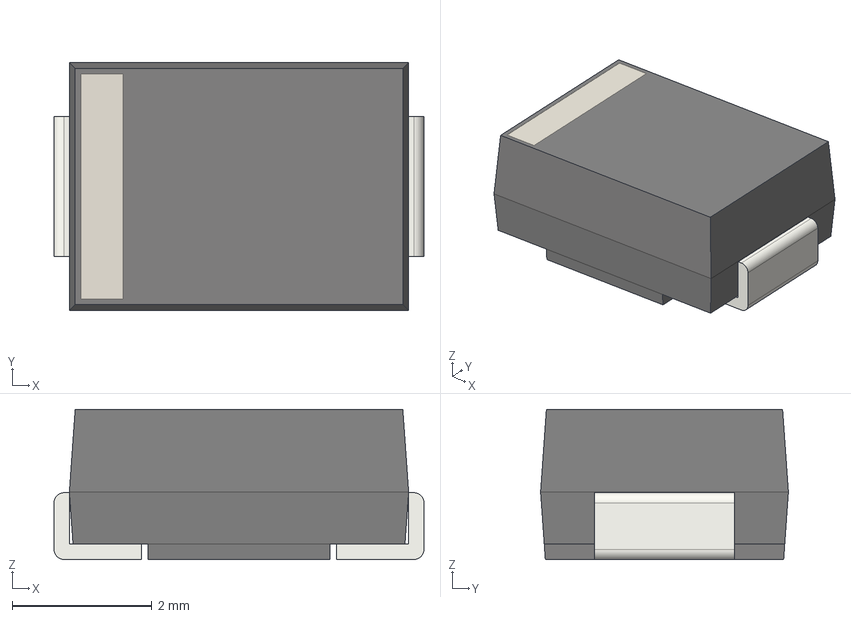
[picture p47: CAD file, 2026-11-12]
kicad/3dmodels/D_SMB.step
5.30 x 3.55 x 2.15 mm
