jarifalamclaude-max/kill-Switch/kicad/3dmodels/CP_Radial_D5.0mm_P2.00mm.step

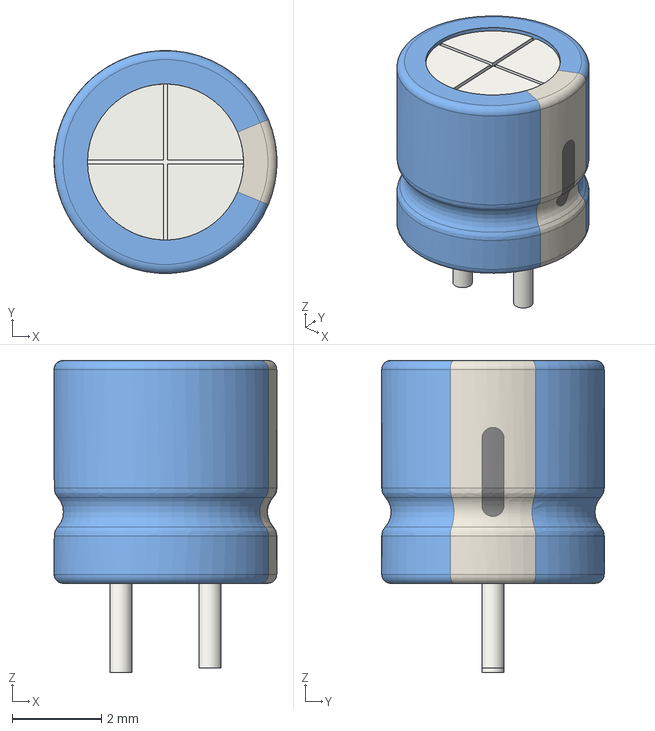
[picture p48: CAD file, 2026-11-12]
kicad/3dmodels/CP_Radial_D5.0mm_P2.00mm.step
5.00 x 5.00 x 7.00 mm
