jarifalamclaude-max/kill-Switch/kicad/3dmodels/TO-220-3_Vertical.step

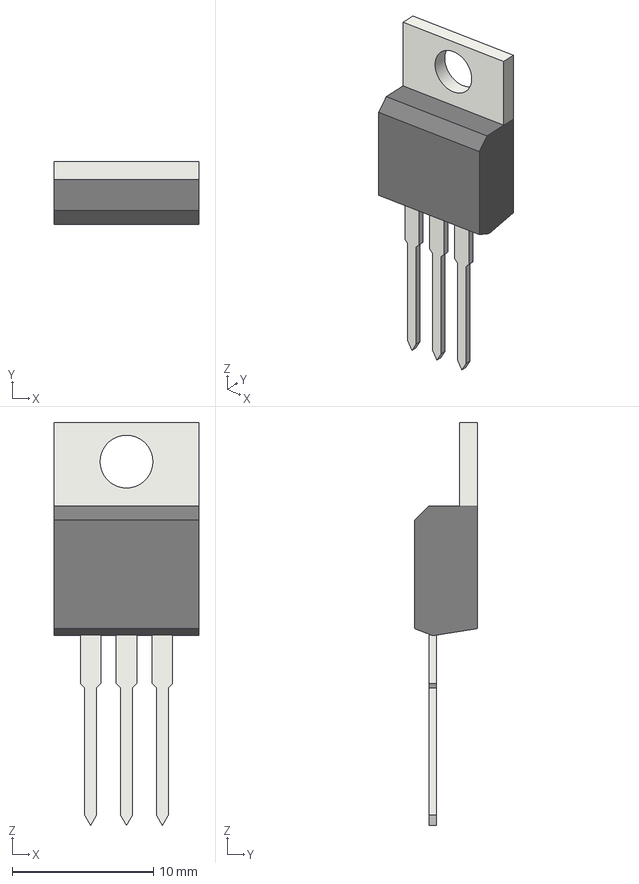
[picture p49: CAD file, 2026-11-12]
kicad/3dmodels/TO-220-3_Vertical.step
10.2 x 4.46 x 28.5 mm
