jarifalamclaude-max/kill-Switch/kicad/3dmodels/D_SMC.step

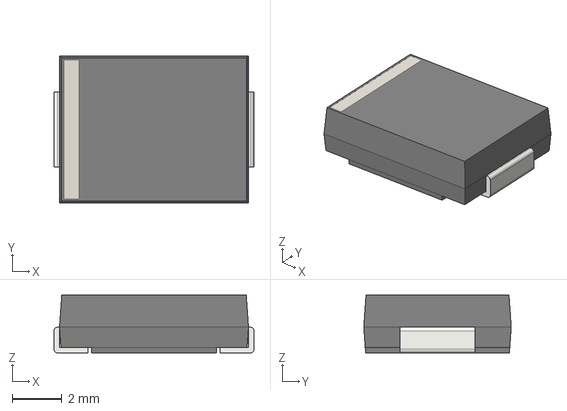
[picture p50: CAD file, 2026-11-12]
kicad/3dmodels/D_SMC.step
8.00 x 5.90 x 2.31 mm
