jarifalamclaude-max/kill-Switch/kicad/3dmodels/LED_D3.0mm.step

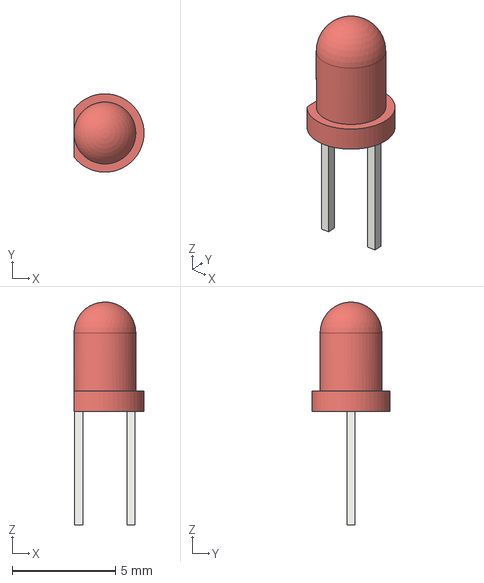
[picture p51: CAD file, 2026-11-12]
kicad/3dmodels/LED_D3.0mm.step
3.40 x 3.80 x 10.8 mm
