jarifalamclaude-max/kill-Switch/kicad/3dmodels/R_2512_6332Metric.step

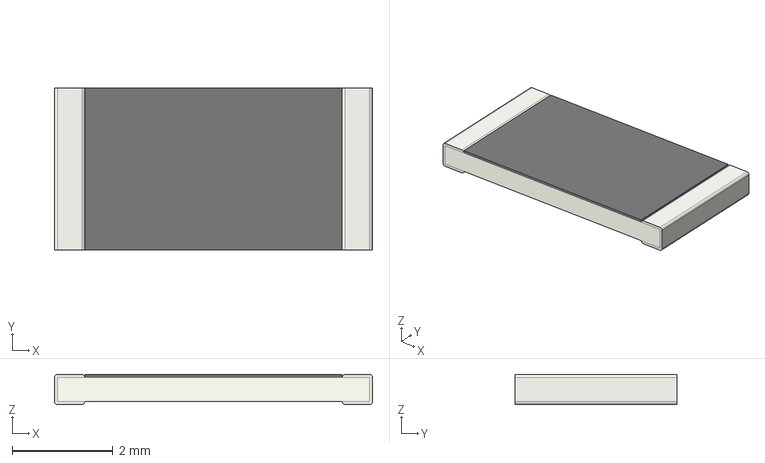
[picture p52: CAD file, 2026-11-12]
kicad/3dmodels/R_2512_6332Metric.step
6.30 x 3.20 x 0.6 mm
