jarifalamclaude-max/kill-Switch/kicad/3dmodels/Infineon_PG-HSOF-8-1.step

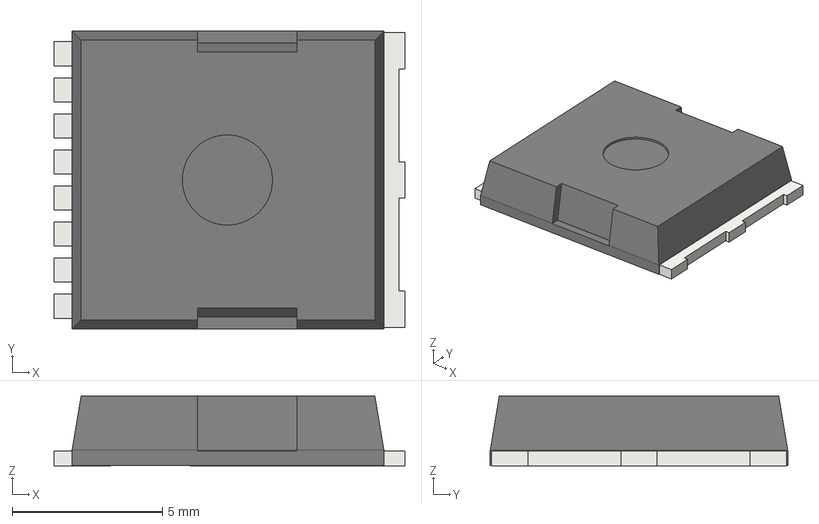
[picture p53: CAD file, 2026-11-12]
kicad/3dmodels/Infineon_PG-HSOF-8-1.step
11.7 x 9.90 x 2.32 mm
ad091e11-9c39-11ed-93f0-dde97e994e83_part
ad091e12-9c39-11ed-93f0-dde97e994e83_part
ad091e13-9c39-11ed-93f0-dde97e994e83_part
