jarifalamclaude-max/kill-Switch/kicad/3dmodels/LED_0805_2012Metric.step

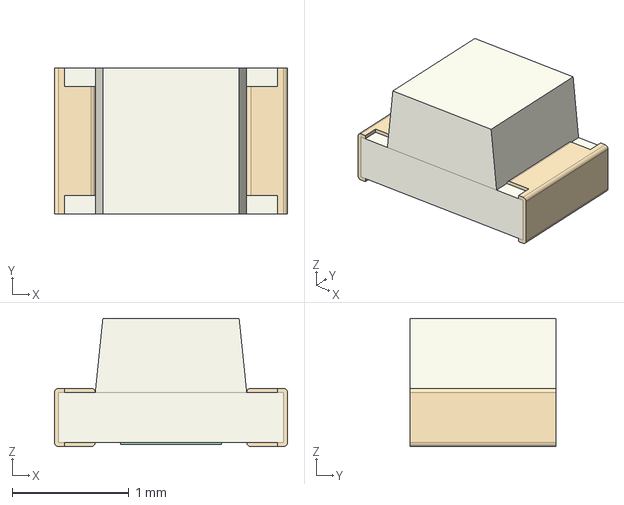
[picture p54: CAD file, 2026-11-12]
kicad/3dmodels/LED_0805_2012Metric.step
2.00 x 1.25 x 1.10 mm
