jarifalamclaude-max/kill-Switch/kicad/3dmodels/TO-92_Inline_Wide.step

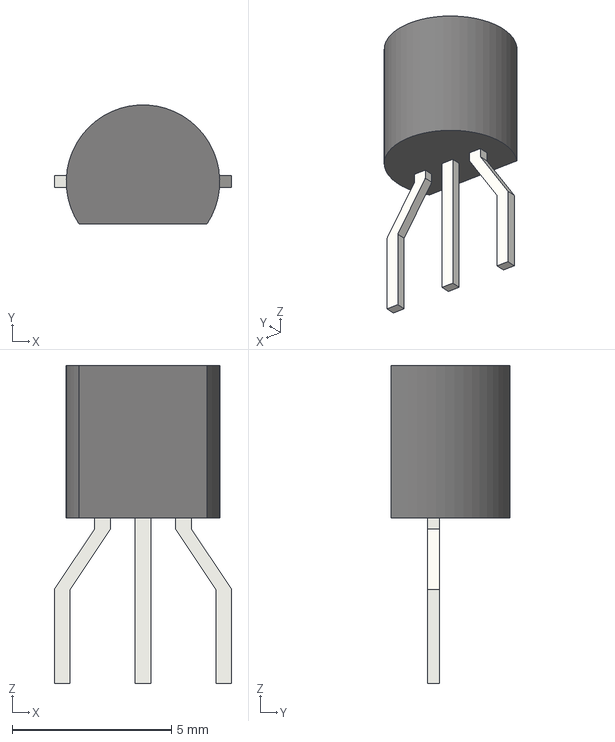
[picture p55: CAD file, 2026-11-12]
kicad/3dmodels/TO-92_Inline_Wide.step
5.58 x 3.74 x 10.0 mm
