jarifalamclaude-max/kill-Switch/kicad/3dmodels/D_SOD-123.step

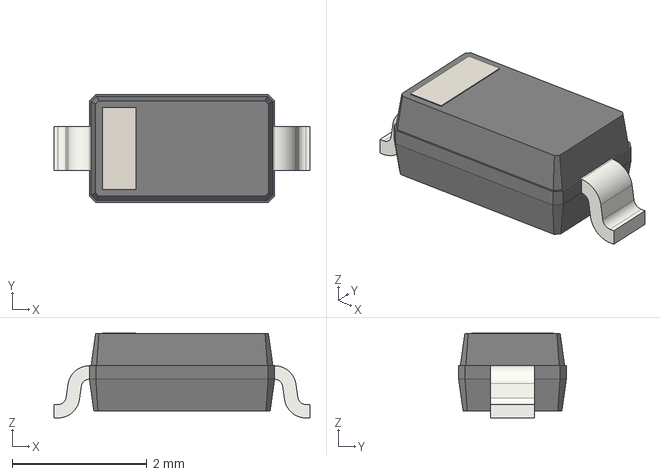
[picture p56: CAD file, 2026-11-12]
kicad/3dmodels/D_SOD-123.step
3.80 x 1.60 x 1.26 mm
