jarifalamclaude-max/kill-Switch/kicad/3dmodels/SOT-23.step

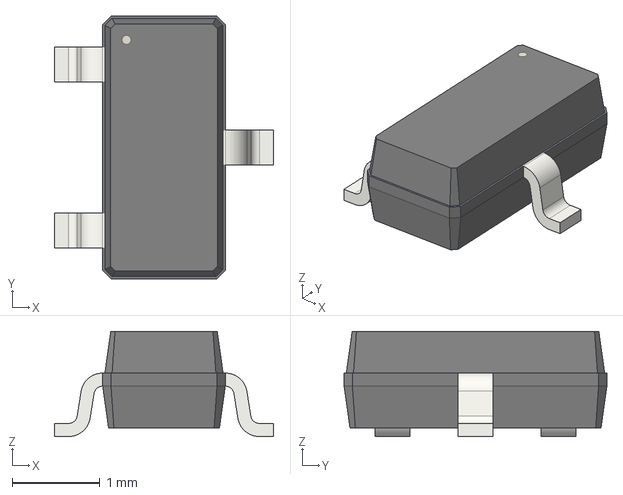
[picture p57: CAD file, 2026-11-12]
kicad/3dmodels/SOT-23.step
2.50 x 3.00 x 1.20 mm
