jarifalamclaude-max/kill-Switch/kicad/3dmodels/D_DO-41_SOD81_P10.16mm_Horizontal.step

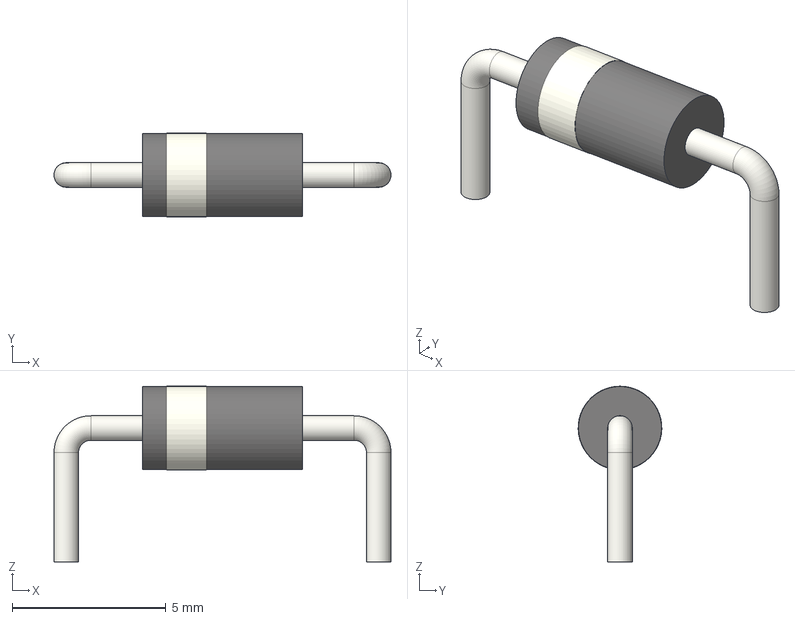
[picture p58: CAD file, 2026-11-12]
kicad/3dmodels/D_DO-41_SOD81_P10.16mm_Horizontal.step
11.0 x 2.72 x 5.71 mm
