jarifalamclaude-max/kill-Switch/kicad/3dmodels/D_DO-15_P10.16mm_Horizontal.step

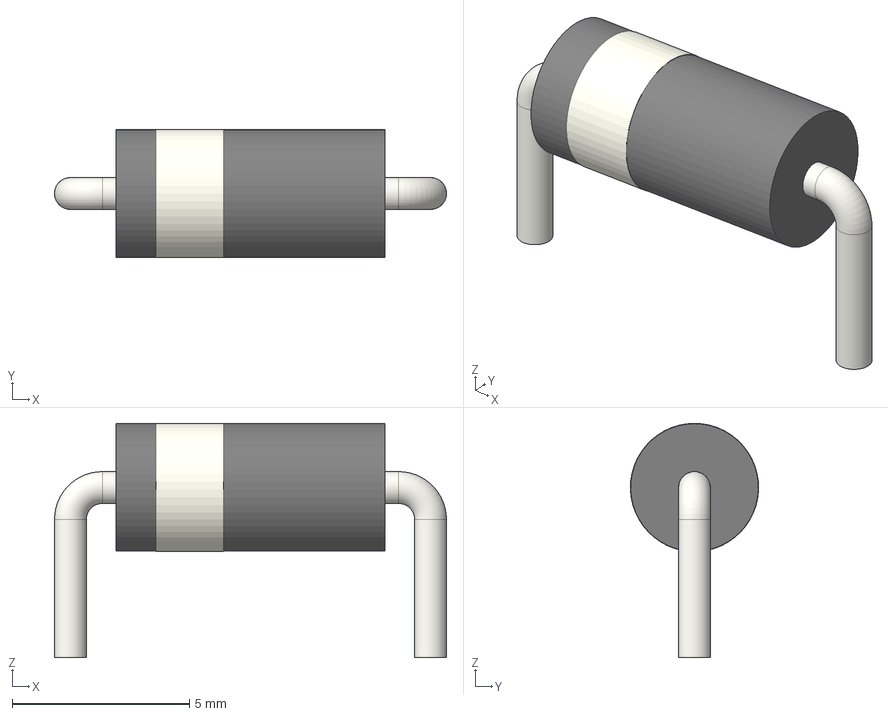
[picture p59: CAD file, 2026-11-12]
kicad/3dmodels/D_DO-15_P10.16mm_Horizontal.step
11.1 x 3.62 x 6.61 mm
