jarifalamclaude-max/kill-Switch/kicad/3dmodels/C_Disc_D5.0mm_W2.5mm_P5.00mm.step

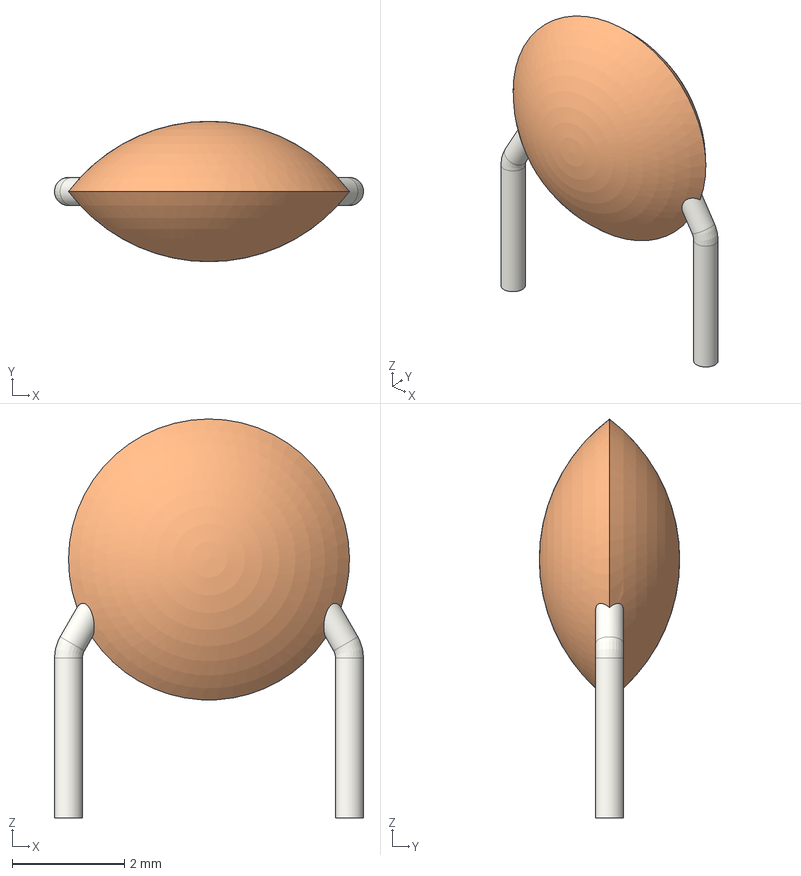
[picture p60: CAD file, 2026-11-12]
kicad/3dmodels/C_Disc_D5.0mm_W2.5mm_P5.00mm.step
5.50 x 2.50 x 7.10 mm
