jarifalamclaude-max/kill-Switch/kicad/3dmodels/DIP-14_W7.62mm.step

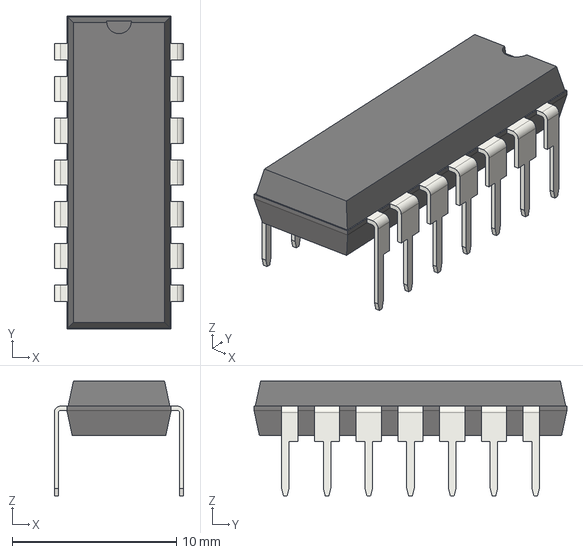
[picture p61: CAD file, 2026-11-12]
kicad/3dmodels/DIP-14_W7.62mm.step
7.87 x 19.1 x 6.98 mm
