jarifalamclaude-max/kill-Switch/kicad/3dmodels/SOP-4_4.4x2.6mm_P1.27mm.step

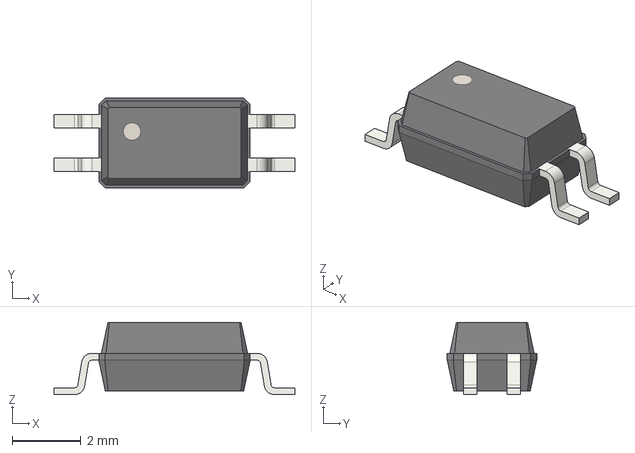
[picture p62: CAD file, 2026-11-12]
kicad/3dmodels/SOP-4_4.4x2.6mm_P1.27mm.step
7.00 x 2.60 x 2.10 mm
