jarifalamclaude-max/kill-Switch/kicad/3dmodels/TO-252-2.step

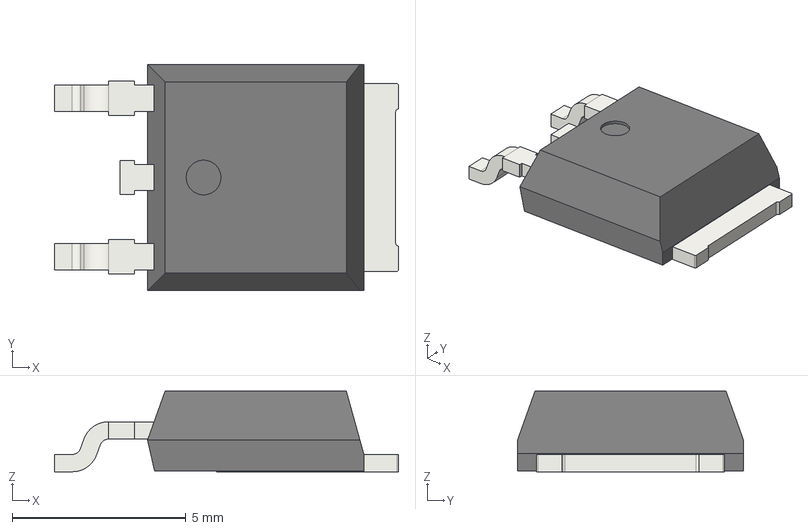
[picture p63: CAD file, 2026-11-12]
kicad/3dmodels/TO-252-2.step
9.90 x 6.50 x 2.32 mm
932d09b3-9c39-11ed-93f0-dde97e994e83_part
932d09b4-9c39-11ed-93f0-dde97e994e83_part
932d09b5-9c39-11ed-93f0-dde97e994e83_part
