jarifalamclaude-max/kill-Switch/docs/board_smd_assembly.png

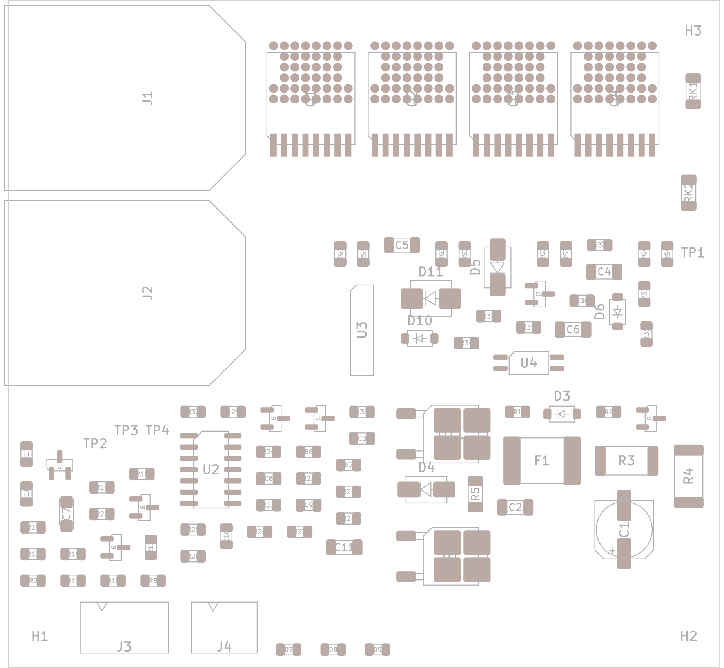
docs/board_smd_assembly.png
