jarifalamclaude-max/kill-Switch/kicad/ks_smd.kicad_pcb

## KiCad design kicad/ks_smd.kicad_pcb (2026-11-12)

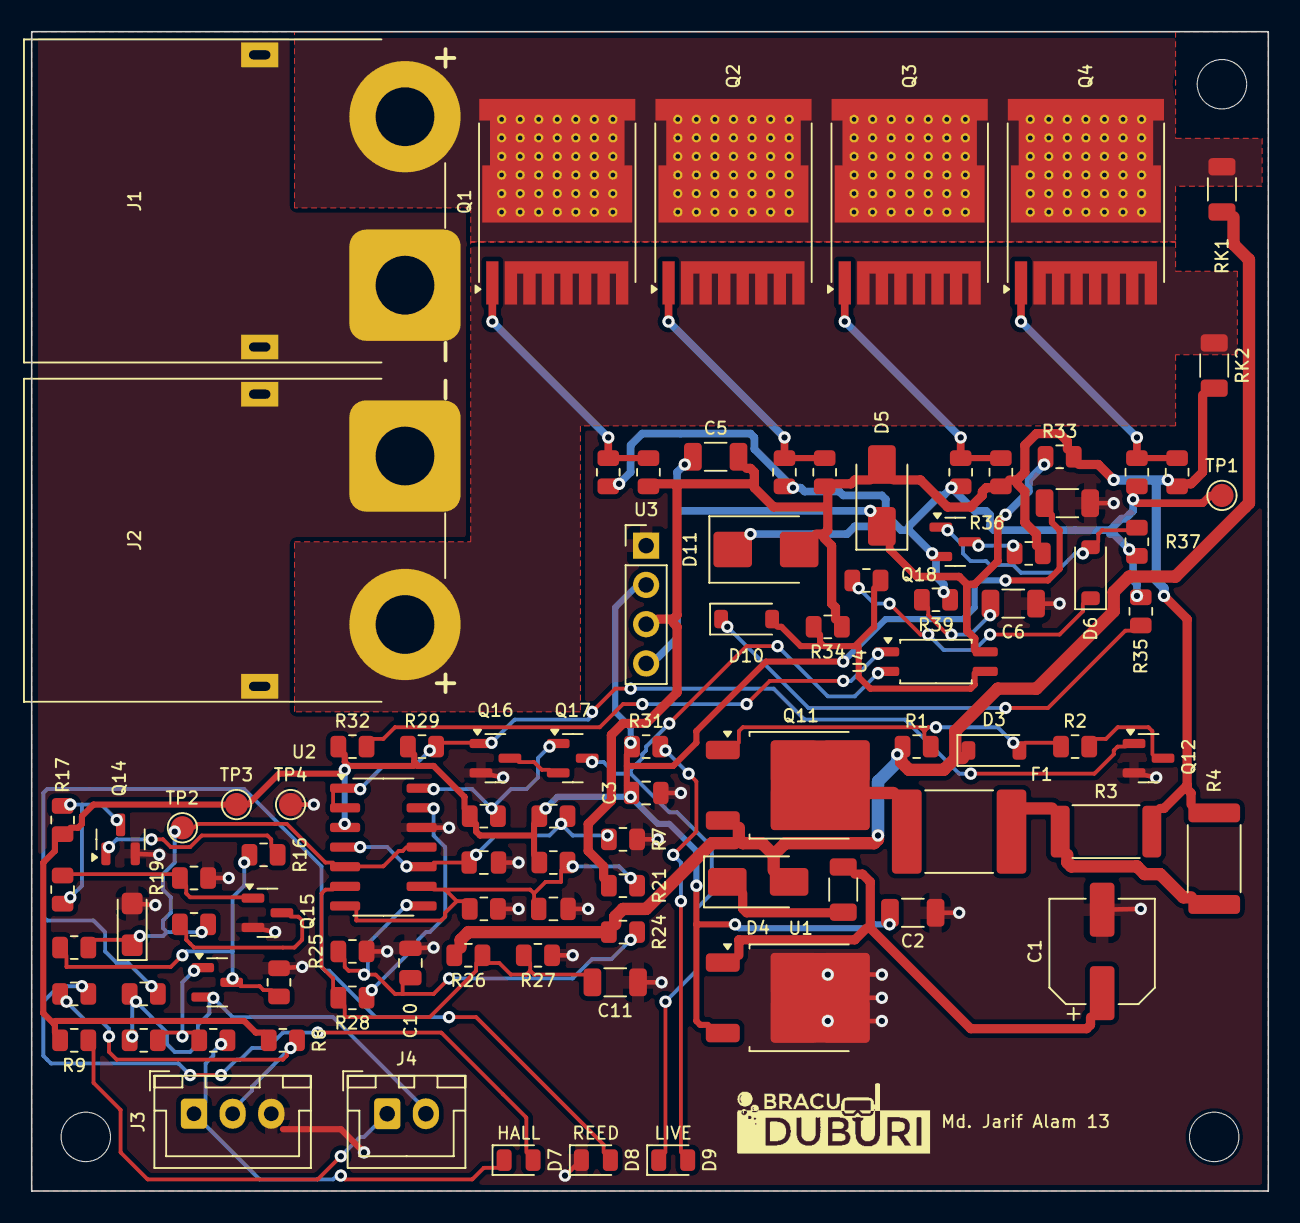
[picture p65: board ks_smd.kicad_pcb from above]

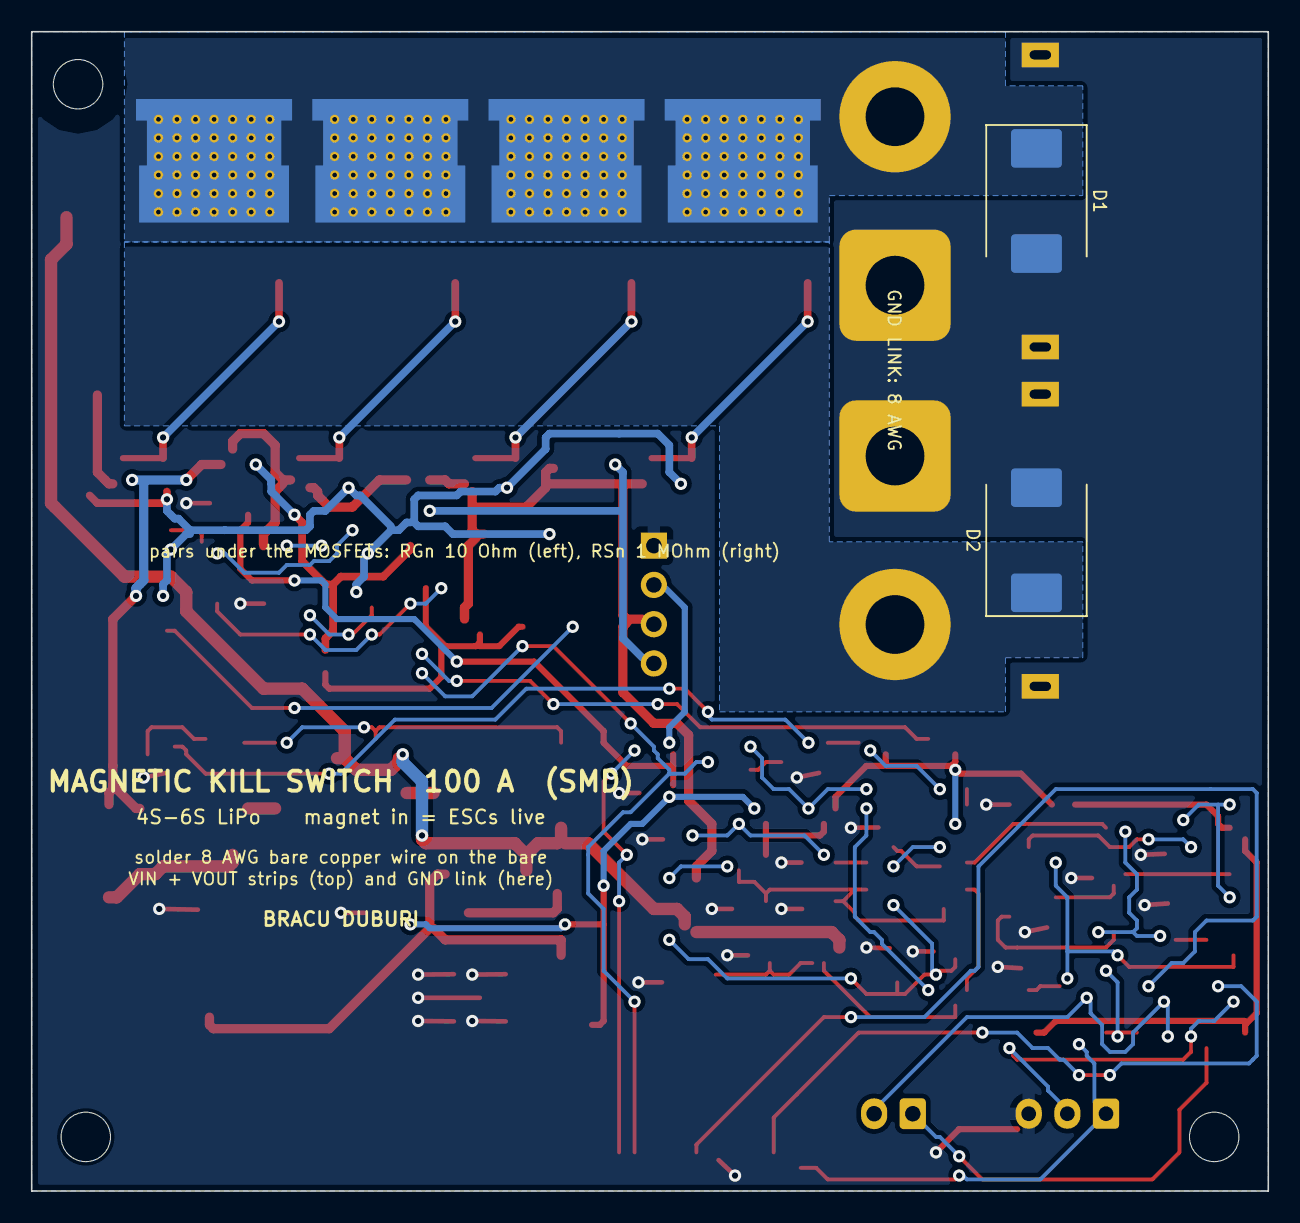
[picture p66: board ks_smd.kicad_pcb from below]

Board: 2 copper layers, 80.0 x 75.0 mm, 99 parts (2 on the bottom side), 48 nets.

Parts:
C1: 47u 50V; CP_Elec_6.3x7.7
C2, C4: 10u 25V; C_1206_3216Metric
C3, C8: 100n; C_0805_2012Metric
C5: 22u 25V; C_1206_3216Metric
C6: 220n 100V X7R; C_1206_3216Metric
C7: 10u 16V tantalum; CP_EIA-3216-18_Kemet-A
C9, C10: 10n; C_0805_2012Metric
C11: 3.3u X7R 50V; C_1206_3216Metric
D1, D2: SMCJ28A; D_SMC
D3: BZT52C12; D_SOD-123
D4: S1M; D_SMA
D5: SMAZ15; D_SMA
D6, D10: 1N4148W; D_SOD-123
D7: blue HALL; LED_0805_2012Metric
D8: blue REED; LED_0805_2012Metric
D9: red LIVE; LED_0805_2012Metric
D11: SMBJ15A; D_SMB
F1: MF-SM050/60-2 (0.5 A, 60 V); Fuse_2920_7451Metric
H1, H2, H3: M3 nylon; MountingHole_3.2mm_M3
J1: XT90PW-M battery IN; AMASS_XT90PW-M_1x02_P10.90mm_Horizontal
J2: XT90PW-F ESC OUT; AMASS_XT90PW-F_1x02_P10.90mm_Horizontal
J3: HALL MODULE (KY-003: S + -); JST_XH_B3B-XH-A_1x03_P2.50mm_Vertical
J4: REED (MC-38); JST_XH_B2B-XH-A_1x02_P2.50mm_Vertical
Q1, Q2, Q3, Q4: IPT007N06N; Infineon_PG-HSOF-8-1_ThermalVias
Q11: FQD11P06; TO-252-2
Q12, Q16, Q17: 2N7002; SOT-23
Q13: MMBT3906; SOT-23
Q14, Q15: MMBT3904; SOT-23
Q18: BC807-40; SOT-23
R1, R11, R37: 47k; R_0805_2012Metric
R2, R34: 22k; R_0805_2012Metric
R3, R4: 22 2512; R_2512_6332Metric
R5: 10; R_1206_3216Metric
R6, R7, R10, R16, R17, R18, R29, R30, R35: 10k; R_0805_2012Metric
R8, R9, R39: 100; R_0805_2012Metric
R12, R33: 4.7k; R_0805_2012Metric
R13, R14, R28, R31, R38: 1k; R_0805_2012Metric
R15, R19: 100k; R_0805_2012Metric
R20: 220; R_0805_2012Metric
R21: 75k 1%; R_0805_2012Metric
R22, R25: 10k 1%; R_0805_2012Metric
R23: 470k; R_0805_2012Metric
R24: 160k 1%; R_0805_2012Metric
R26: 1M; R_0805_2012Metric
R27: 68k; R_0805_2012Metric
R32: 330; R_0805_2012Metric
R36: 47; R_0805_2012Metric
RG1, RG2, RG3, RG4: 10; R_0805_2012Metric
RK1, RK2: 0R; R_1206_3216Metric
RS1, RS2, RS3, RS4: 1M; R_0805_2012Metric
TP1: FG; TestPoint_Pad_D1.5mm
TP2: EN; TestPoint_Pad_D1.5mm
TP3: V5; TestPoint_Pad_D1.5mm
TP4: GND; TestPoint_Pad_D1.5mm
U1: L7805CDT; TO-252-2
U2: LM339D; SOIC-14_3.9x8.7mm_P1.27mm
U3: B0512S-1WR3; PinHeader_1x04_P2.54mm_Vertical
U4: EL357N; SOP-4_4.4x2.6mm_P1.27mm

Connections:
ARM: Q13.3, R12.1, R15.1, R16.1
CATH: D9.1, Q17.3, U4.2
DONE: Q17.1, R30.2, U2.14
DRV: D10.2, R34.1, R38.2, U4.3
DRVD: D10.1, R35.1
EN: C7.1, R15.2, R20.2, TP2.1, U2.5, U2.11
FG: D11.1, Q18.2, R35.2, R37.1, R39.2, RG1.2, RG2.2, RG3.2, RG4.2, TP1.1
FGC: C6.1, R39.1
G1: Q1.1, RG1.1, RS1.1
G2: Q2.1, RG2.1, RS2.1
G3: Q3.1, RG3.1, RS3.1
G4: Q4.1, RG4.1, RS4.1
GND: C1.2, C2.2, C3.2, C4.2, C6.2, C7.2, C8.2, C9.2, C10.2, C11.2, D1.2, D2.2, D8.1, J1.1, J1.MP, J2.1, J2.MP, J3.3, Q12.2, Q14.2, Q15.2, Q16.2, R7.2, R12.2, R19.2, R22.2, R25.2, R27.2, TP4.1, U1.2, U2.12, U3.1
HALL: D7.1, J3.1, R10.2
HLA: D7.2, R13.2
LVA: D9.2, R31.2
NARM: Q14.3, R17.2, R18.1
PCD: F1.1, Q11.2
PCDN: Q12.3, R2.2
PCEN: Q12.1, Q16.1, R29.2, U2.1, U2.2
PCF: F1.2, R3.1, R4.1
PCG: D3.2, Q11.1, R1.2, R2.1
QAB: Q13.1, R10.1, R11.2
QDB: Q15.1, R18.2, R19.1
QDC: Q15.3, R20.1
QGM: Q16.3, Q17.2
QIB: Q14.1, R16.2
QOB: D6.2, Q18.1, R37.2
QOC: Q18.3, R36.1
QOD: D6.1, R38.1
RAMP: C11.1, R26.2, R27.1, R28.1, U2.6
REF: C8.1, R6.2, R7.1, U2.4, U2.10
RIN: J4.1, R9.2
RLA: D8.2, R14.2
ROUT: J4.2, Q13.2, R11.1, R14.1
RRST: R28.2, U2.13
SRC: C5.2, D5.2, D11.2, R3.2, R4.2, R21.1, R33.2, R34.2, R36.2, RK2.2, RS1.2, RS2.2, RS3.2, RS4.2, U3.3
UGA: R32.2, U4.1
V5: C2.1, C3.1, C4.1, R6.1, R8.1, R9.1, R17.1, R23.1, R29.1, R30.1, R31.1, R32.1, TP3.1, U1.3, U2.3, U3.2
V5S: J3.2, R8.2, R13.1
V12F: C5.1, D5.1, R33.1, U3.4, U4.4
VIN: D1.1, J1.2, Q1.3, Q2.3, Q3.3, Q4.3, RK1.1
VIND: C10.1, R24.2, R25.1, U2.8
VIN_K: D3.1, D4.2, Q11.3, R1.1, R24.1, R26.1, RK1.2
VOD: C9.1, R21.2, R22.1, R23.2, U2.7, U2.9
VOUT: D2.1, J2.2, Q1.2, Q2.2, Q3.2, Q4.2, RK2.1
VR1: D4.1, R5.1
VR2: C1.1, R5.2, U1.1
