jarifalamclaude-max/kill-Switch/kicad/ks_power.kicad_pcb

## KiCad design kicad/ks_power.kicad_pcb (2026-11-12)

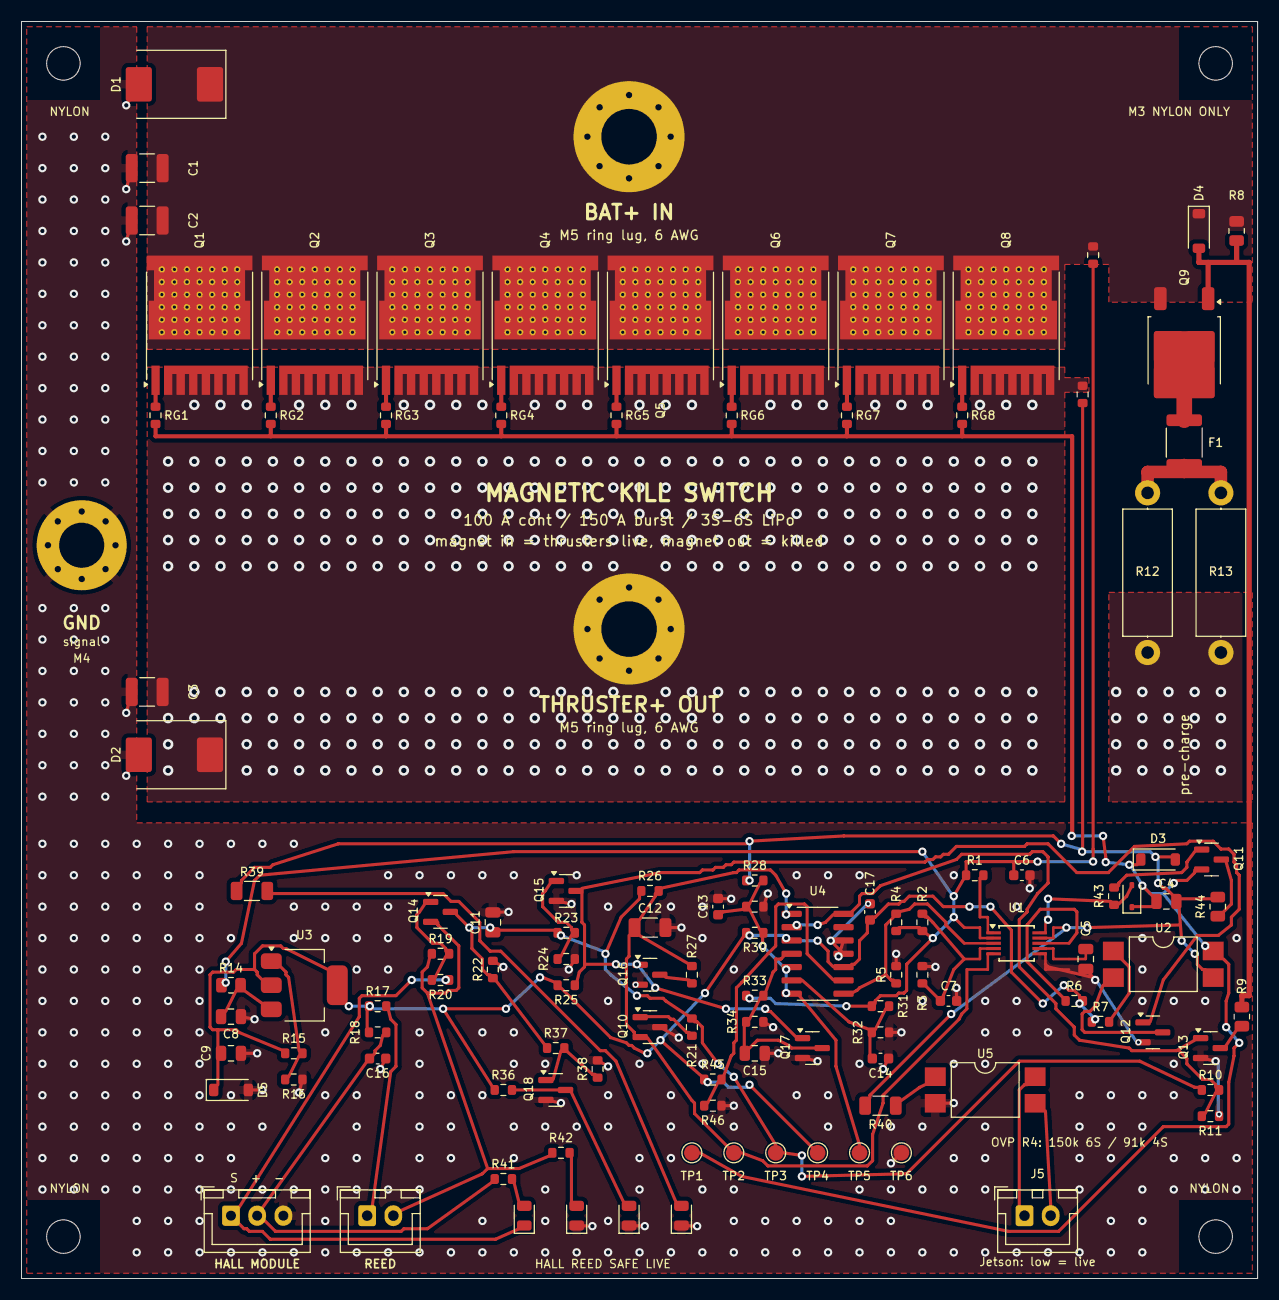
[picture p67: board ks_power.kicad_pcb from above]

Board: 2 copper layers, 118.0 x 120.0 mm, 121 parts (0 on the bottom side), 55 nets.

Parts:
C1, C2, C3: 2.2u 100V; C_1210_3225Metric
C4: 47n 50V; C_0805_2012Metric
C5: 470n; C_0805_2012Metric
C6: 100n 100V; C_0603_1608Metric
C7, C13, C14: 10n; C_0603_1608Metric
C8: 1u 50V; C_0805_2012Metric
C9: 10u 16V; C_0805_2012Metric
C11: 2.2u; C_0805_2012Metric
C12: 22u 16V; C_1206_3216Metric
C15: 3.3u; C_0805_2012Metric
C16, C17: 100n; C_0603_1608Metric
D1: SMDJ26A; D_SMC
D2: SMCJ26A; D_SMC
D3: BZT52C15; D_SOD-123
D4: BZT52C12; D_SOD-123
D5: BZT52C6V2; D_SOD-123
D6: blue HALL; LED_0805_2012Metric
D7: blue REED; LED_0805_2012Metric
D8: green SAFE; LED_0805_2012Metric
D9: BAT54WS; D_SOD-323
F1: PTC 0.5A 30V 1812; Fuse_1812_4532Metric
H1, H2, H3, H4: M3 nylon; MountingHole_3.2mm_M3
J1: BAT+ IN (M5); MountingHole_5.3mm_M5_Pad_Via
J2: THRUSTER+ OUT (M5); MountingHole_5.3mm_M5_Pad_Via
J3: GND (M4); MountingHole_4.3mm_M4_Pad_Via
J4: HALL MODULE (KY-003: S + -); JST_XH_B3B-XH-A_1x03_P2.50mm_Vertical
J5: STATUS to Jetson; JST_XH_B2B-XH-A_1x02_P2.50mm_Vertical
J6: REED CONTACT (MC-38); JST_XH_B2B-XH-A_1x02_P2.50mm_Vertical
LED1: red LIVE; LED_0805_2012Metric
Q1, Q2, Q3, Q4, Q5, Q6, Q7, Q8: IPT007N06N; Infineon_PG-HSOF-8-1_ThermalVias
Q9: FQD11P06; TO-252-2
Q10, Q11: MMBT3906; SOT-23
Q12, Q13, Q15, Q16, Q17, Q18: 2N7002; SOT-23
Q14: BSS84; SOT-23
R1: 4.32k 1%; R_0603_1608Metric
R2, R34: 47k; R_0603_1608Metric
R3, R5, R20, R23, R37: 10k; R_0603_1608Metric
R4: 150k; R_0603_1608Metric
R6, R10, R19, R24, R25, R26, R38: 100k; R_0603_1608Metric
R7, R36, R41, R42, R43: 1k; R_0603_1608Metric
R8: 47k; R_0805_2012Metric
R9: 22k; R_0805_2012Metric
R11, R30, R33: 1M; R_0603_1608Metric
R12, R13: 22 2W; R_Axial_DIN0414_L11.9mm_D4.5mm_P15.24mm_Horizontal
R14: 10; R_0805_2012Metric
R15: 240 1%; R_0603_1608Metric
R16: 750 1%; R_0603_1608Metric
R17, R18: 100; R_0603_1608Metric
R21: 4.7k; R_0603_1608Metric
R22: 2.2k; R_0603_1608Metric
R27: 10; R_0603_1608Metric
R28: 90.9k 1%; R_0603_1608Metric
R29, R32, R46: 10k 1%; R_0603_1608Metric
R31: 191k 1%; R_0603_1608Metric
R39: 4.7k; R_1206_3216Metric
R40: 10k; R_1206_3216Metric
R44: 220; R_0805_2012Metric
R45: 15.8k 1%; R_0603_1608Metric
RG1, RG2, RG3, RG4, RG5, RG6, RG7, RG8: 10; R_0603_1608Metric
RK1: 0R (VIN Kelvin); R_0603_1608Metric
RK2: 0R (VOUT Kelvin); R_0603_1608Metric
TP1: FG; TestPoint_Pad_D1.5mm
TP2: EN; TestPoint_Pad_D1.5mm
TP3: ARM; TestPoint_Pad_D1.5mm
TP4: V5; TestPoint_Pad_D1.5mm
TP5: VOD; TestPoint_Pad_D1.5mm
TP6: GND; TestPoint_Pad_D1.5mm
U1: LM5060; MSOP-10_3x3mm_P0.5mm
U2: PC817 (gate kill); SMDIP-4_W9.53mm
U3: LM317; SOT-223-3_TabPin2
U4: LM339; SOIC-14_3.9x8.7mm_P1.27mm
U5: PC817 (status); SMDIP-4_W9.53mm

Connections:
ADJ: R15.2, R16.1, U3.1
ARM: C11.1, Q14.3, R10.1, R21.2, R22.1, R23.1, R26.1, R37.1, TP3.1
ARMG: Q15.1, R23.2, R24.1
EN: C12.1, Q10.2, R26.2, R27.2, TP2.1, U1.5, U4.1
END: Q16.3, R27.1
FG: C4.1, D3.1, D9.1, Q11.2, RG1.2, RG2.2, RG3.2, RG4.2, RG5.2, RG6.2, RG7.2, RG8.2, TP1.1, U2.4
G1: Q1.1, RG1.1
G2: Q2.1, RG2.1
G3: Q3.1, RG3.1
G4: Q4.1, RG4.1
G5: Q5.1, RG5.1
G6: Q6.1, RG6.1
G7: Q7.1, RG7.1
G8: Q8.1, RG8.1
GDRV: D9.2, R43.1, U1.10
GND: C1.1, C2.1, C3.1, C5.2, C6.2, C7.2, C8.2, C9.2, C11.2, C12.2, C13.2, C14.2, C15.2, C16.2, C17.2, D1.2, D2.2, D5.2, D7.1, D8.1, J3.1, J4.3, LED1.1, Q10.3, Q12.2, Q13.2, Q15.2, Q16.2, Q17.2, Q18.2, R3.2, R5.2, R11.2, R16.2, R22.2, R24.2, R29.2, R32.2, R34.2, R38.2, R46.2, TP6.1, U1.6, U4.11, U4.12, U5.2
HALL: D6.1, J4.1, R20.2
HG: Q14.1, R19.2, R20.1
HLA: D6.2, R41.2
KA: R7.2, U2.1
KC: Q12.3, U2.2
LIVEA: LED1.2, R39.2
LSAFE: D8.2, Q18.3, R36.2
NARM: Q12.1, Q15.3, Q16.1, Q17.1, R25.2
OVP: R4.2, R5.1, U1.3, U4.8
PCD: F1.1, Q9.2
PCEN: Q13.1, R10.2, R11.1, U4.2, U4.14
PCF: F1.2, R12.1, R13.1
PCG: D4.2, Q9.1, R8.2, R9.1
PDRV: Q13.3, R9.2
PGD: R6.1, U1.8
PNB: Q10.1, R21.1
PNB2: Q11.1, R43.2
QOFF: Q11.3, R44.1
RAMP: C15.1, Q17.3, R33.2, R34.1, U4.4
REF2: R45.2, R46.1, U4.9
RIN: J6.1, R17.2
RLA: D7.2, R42.2
ROUT: J6.2, Q14.2, R19.1, R42.1
SAFEG: Q18.1, R37.2, R38.1
SNS: R1.2, U1.1
STA: R40.2, U5.1
STC: J5.1, U5.4
STE: J5.2, U5.3
TMR: C5.1, U1.7
UV: C7.1, R2.2, R3.1, U1.4
V5: C9.1, C17.1, D5.1, R6.2, R7.1, R15.1, R17.1, R18.1, R25.1, R30.1, R36.1, R45.1, TP4.1, U3.2, U4.3, U4.10
V5S: C16.1, J4.2, R18.2, R41.1
VIN: C1.2, C2.2, D1.1, D4.1, J1.1, Q1.3, Q2.3, Q3.3, Q4.3, Q5.3, Q6.3, Q7.3, Q8.3, Q9.3, R8.1, RK1.1
VIND: C14.1, R31.2, R32.1, U4.6
VINL: C8.1, R14.2, U3.3
VIN_K: C6.1, R1.1, R2.1, R4.1, R14.1, R31.1, R33.1, RK1.2, U1.2
VOD: C13.1, R28.2, R29.1, R30.2, TP5.1, U4.5, U4.7
VOUT: C3.2, D2.1, J2.1, Q1.2, Q2.2, Q3.2, Q4.2, Q5.2, Q6.2, Q7.2, Q8.2, R12.2, R13.2, RK2.1
VOUT_K: C4.2, D3.2, R28.1, R39.1, R40.1, R44.2, RK2.2, U1.9, U2.3
