jarifalamclaude-max/kill-Switch/(commit log)

2026-11-12 Magnetic kill switch: PCB, design numbers, simulations, gerbers
    Solid-state kill switch for an underwater robot, 100 A continuous and
    150 A burst on 3S-6S LiPo:
    - Hall module (KY-003) and reed contact (MC-38) in series arm the switch
    - LM5060 high-side controller driving 8 x IPT007N06N in parallel
    - pre-charge with short detection and over-voltage block (LM339)
    - PNP fast turn-off, TVS clamps, opto second kill path, status LEDs
    - KiCad board 118 x 120 mm, 2 oz, DRC 0 violations / 0 unconnected
    - design_calc.py: magnet field, sensor placement, losses, timing
    - 15 ngspice scenarios from the PCB netlist, all pass
    - gerbers, drill files and grouped BOM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
    [bom_grouped.csv, bom_power.csv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]
2026-11-12 Through-hole kill switch: XT60 in/out, 4 x IRFB3206, 45-degree routing
    New main version, every part through-hole, for 4S-6S LiPo:
    - XT60 battery input and XT60 ESC output (30 A continuous / 60 A burst)
    - 4 x IRFB3206 high-side switch, gates from an isolated B0512S
    supply through a PC817, BC327 fast turn-off, soft start, TVS clamps
    - one LM339: arm delay, pre-charge with shorted-bus abort, main switch
    only above VOUT > 0.5 VIN, trips on a short while running
    - KY-003 Hall + MC-38 reed in series, 1.6 ms kill, 0.8 ms gaps ignored
    - 120 x 98 mm board, tracks with 45-degree bends only, DRC 0/0,
    BRACU Duburi logo and designer name on the silkscreen
    - 15 ngspice scenarios from the PCB netlist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
    [bom_tht.csv, bom_tht_grouped.csv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]
2026-11-12 Cleaner through-hole routing, 3D models for KiCad 7/8/9
    - router joins points with one straight and one 45-degree segment
    instead of a staircase of short pieces
    - 0.45 mm from tracks to other copper and no track between the pins
    of a part (room for hand soldering); component bodies are costly
    for the router, so tracks go around them unless there is no room
    - B.Cu kept clear under the power section for the GND current
    between the XT60s; isolated GND pads get a track to the main pour
    - every footprint model now also points at KICAD7/8/9_3DMODEL_DIR, so
    the parts show in the 3D viewer of newer KiCad versions (both boards)
    - DRC 0 violations / 0 unconnected; gerbers and zips rebuilt
    C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
    [ks_power.kicad_pcb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]
2026-11-12 WIP: veroboard, 3D board page and tutorial being redone for the THT board
    Snapshot of the page work in progress (veroboard plan, 3D current-flow
    page, enclosure tutorial, dock and plug model). These folders still
    target the earlier SMD board in places and are being reworked for
    ks_tht.kicad_pcb; the finished versions follow in the next commit.
    Claude-Session: https://claude.ai/code/session_01L6HZDtvG76sHxffRPrD4gh
    [dock_plug.scad]
2026-11-12 THT board fixes from the final simulation run; pages still in progress
    Board (DRC 0 violations / 0 unconnected, gerbers and zips rebuilt):
    - the gate bus now leaves the power section at its right end and VIN_K
    runs on F.Cu, so the B.Cu GND plane between the two XT60s is no longer
    squeezed through a narrow neck (copper simulation found 18 A/mm there
    at 60 A); the pre-charge resistors join VOUT underneath at RK2
    - bare copper strips (no solder mask) along the VIN and VOUT paths on top
    and the GND path underneath, to solder a 12 AWG bare wire on: the
    copper itself was losing 2.5 W at 30 A, three times the MOSFETs
    - R39 100 Ohm in series with the soft-start capacitor: gate peak in a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
    [bom_tht.csv, bom_tht_grouped.csv, dock_plug.scad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]
2026-11-12 WIP: veroboard page for the THT board, worst-case opto results so far
    Veroboard plan being regenerated from ks_tht.kicad_pcb; first results of
    the worst-case PC817 (CTR 50%) run on the final board. Both still in
    progress.
    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
2026-11-12 SIMULATION_RESULT.md: final run on the finished through-hole board
    - 15 circuit scenarios on the final board: all pass
    - worst-case PC817 (CTR 50 %): no change beyond 0.05 ms / 0.1 V
    - DC current solve of the board's copper (as etched and with 12 AWG
    wire on the bare strips): current share of the 4 MOSFETs, copper
    resistance, loss at 30 A and 60 A, current-density maps
    - the three fixes this run led to (GND neck, bare strips, R39)
    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
2026-11-12 Veroboard plan for the through-hole kill switch
    Perfboard layout generated from ks_tht.kicad_pcb (48 x 39 holes, 96
    parts, no hole collisions); the 30-60 A paths as bare 12 AWG runs with
    XT60 pigtails; schematic drawn from the PCB netlist (all 218 pins
    match), wire list and parts list.
    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
2026-11-12 Add the through-hole board's schematic (PNG and SVG) to docs
    Drawn from the ks_tht.kicad_pcb netlist; all 218 pins match.
    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
2026-11-12 WIP: 3D board page and tutorial scene for the through-hole board
    Still being built (3D current-flow page generator, tutorial scene);
    committed so the work in progress is saved.
    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
2026-11-12 WIP: 3D board page and tutorial scene, latest state
    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
    [bracket.stl, dock.stl, handle.stl, plug.stl]
2026-11-12 3D current-flow page for the through-hole board; README numbers from the final run
    pcb-3d/: every footprint in 3D at its real place, textures from
    ks_tht.kicad_pcb, seven current paths on the real copper (main 30/60 A
    with the 12 AWG wires, pre-charge, gate drive, arm chain, sequencing,
    kill, 5 V) and a card for every part.
    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
2026-11-12 Tutorial video and 3D scene, mechanics STLs, README folder list
    - 3d/: 64 s video (1280x720, h264) and an interactive three.js scene:
    a diver pulls the magnet plug, LIVE goes off in 1.6 ms, the plug is
    parked and re-armed (0.8 s pre-charge and live in slow motion), the
    0.8 ms vibration gap is ignored, then the pre-dive checklist
    - mech/: dock, plug, T-handle and sensor bracket as STL, spec.json
    updated for the through-hole board
    - README lists the veroboard, 3D board, tutorial and simulation result
    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
2026-11-12 100 A kill switch: XT90 through-hole board (8x IRFB3206) and small SMD board (4x IPT007N06N)
    Through-hole board rebuilt for 100 A: XT90 in/out on the left edge, 8 MOSFETs,
    bare strips for 8 AWG wire, R37 47k for a full gate turn-off. New 80 x 75 mm
    SMD board with the same circuit. Both DRC clean; 15 scenarios pass on each.
    3D models are bundled in kicad/3dmodels via KIPRJMOD so the 3D view works in
    KiCad 7-10; green stackup; green board renders.
    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
    [CP_EIA-3216-18_Kemet-A.step, CP_Elec_6.3x7.7.step, CP_Radial_D5.0mm_P2.00mm.step, CP_Radial_D6.3mm_P2.50mm.step, C_0805_2012Metric.step, C_1206_3216Metric.step, C_Disc_D5.0mm_W2.5mm_P5.00mm.step, C_Rect_L7.2mm_W3.5mm_P5.00mm_FKS2_FKP2_MKS2_MKP2.step]
2026-11-12 SMD copper solve fixed (SMD pads on their own layer), SIMULATION_RESULT for both 100 A boards, veroboard and schematic for the 100 A board
    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
    [bom_smd_grouped.csv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]
2026-11-12 3D board page for the 100 A through-hole board (green, XT90, 8 MOSFETs, 8 AWG wire current path)
    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
2026-11-12 Tutorial video for the 100 A board with an English voice-over (86 s)
    Scene rebuilt from the 100 A board (XT90 in/out, 8 MOSFETs turned 180 degrees,
    8 AWG wires, new callouts and captions, 1.5 ms kill). Piper text-to-speech
    lines in 3d/narration; render_video.js stretches the scene where a line needs
    more time and mixes the voice into the video.
    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
2026-11-13 Sensor mounting guide: 3D video with voice-over showing where the Hall and reed sensors go and how to fit them
    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
2026-11-13 Pick-and-place (CPL) files for assembly
    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
    [ks_smd-B_Cu.gbl, ks_smd-B_Mask.gbs, ks_smd-B_Paste.gbp, ks_smd-B_Silkscreen.gbo, ks_smd-Edge_Cuts.gm1, ks_smd-F_Cu.gtl, ks_smd-F_Mask.gts, ks_smd-F_Paste.gtp]
2026-11-13 JLCPCB assembly files (BOM and CPL in JLCPCB format) for the SMD board
    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
    [BOM_ks_smd.csv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]
