jarifalamclaude-max/kill-Switch/(notices)

Notices in the files:
kicad/3dmodels/C_1206_3216Metric.step:
Copyright (C) 2017, kicad StepUp
This work is licensed under the [Creative Commons CC-BY-SA 4.0 License](https://creativecommons.org/licenses/by-sa/4.0/legalcode),
with the following exception:
To the extent that the creation of electronic designs that use 'Licensed Material' can be considered to be 'Adapted Material',
You are free to use the library data in your own projects without the obligation to share your project files under this or any other license agreement.
kicad/3dmodels/D_SMA.step:
This program is free software: you can redistribute it and/or modify
it under the terms of the GNU General Public License as published by
the Free Software Foundation, either version 3 of the License, or
any later version.
itself might be covered by the GNU General Public License.
kicad/3dmodels/R_2512_6332Metric.step:
Copyright (C) 2018, kicad StepUp
kicad/3dmodels/JST_XH_B2B-XH-A_1x02_P2.50mm_Vertical.step:
Copyright (C) 2019, Rene Poeschl
kicad/3dmodels/DIP-14_W7.62mm.step:
Copyright (C) 2017, your name
kicad/3dmodels/SOIC-14_3.9x8.7mm_P1.27mm.step:
Copyright (C) 2025, KiCAD
This work is licensed under the
[Creative Commons CC-BY-SA 4.0 License](https://creativecommons.org/licenses/by-sa/4.0/legalcode),
project files under this or any other license agreement. However, if you wish to distribute
kicad/3dmodels/TO-252-2.step:
Copyright (C) 2023, Ray Benitez
